Nortcel/cosine-response-test-bench/licenses/README.txt

Licence allocation
Original hardware design files: CERN-OHL-S-2.0.
Original controller, firmware and analysis code: MIT.
Original documentation, photographs and datasets: CC-BY-4.0.
Third-party components retain their own terms. Preserve existing notices. See THIRD_PARTY_MATERIALS.txt.
The root repository MIT licence does not override these per-material allocations.
