Nortcel/cosine-response-test-bench/data/optical_graph_transcription/Historical_graph_with_labels.jpg

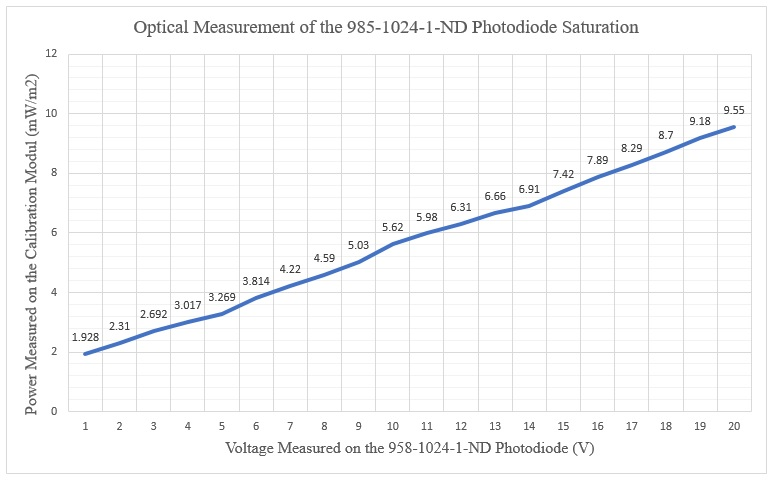
data/optical_graph_transcription/Historical_graph_with_labels.jpg
