Nortcel/cosine-response-test-bench/data/optical_graph_transcription/source_images/image2.png

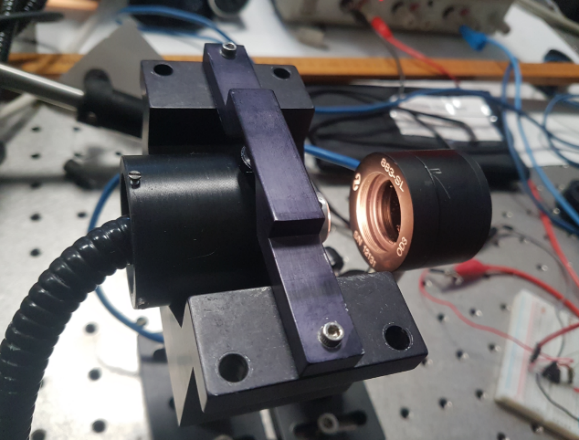
data/optical_graph_transcription/source_images/image2.png
