Nortcel/cosine-response-test-bench/data/optical_graph_transcription/source_images/image4.png

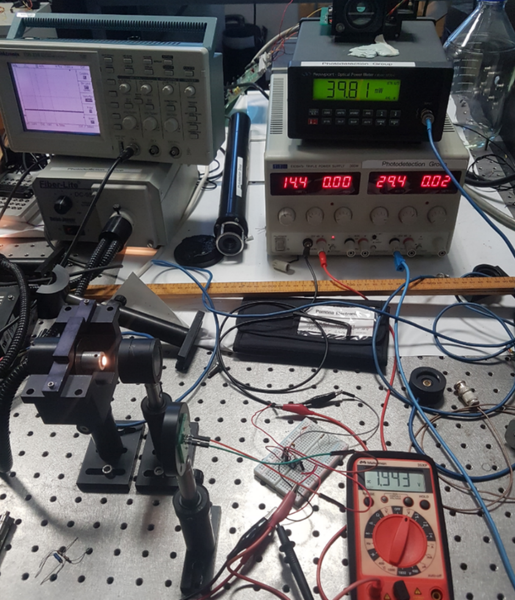
data/optical_graph_transcription/source_images/image4.png
