Nortcel/cosine-response-test-bench/figures/Figure_4_desktop_controller_V26_7.jpg

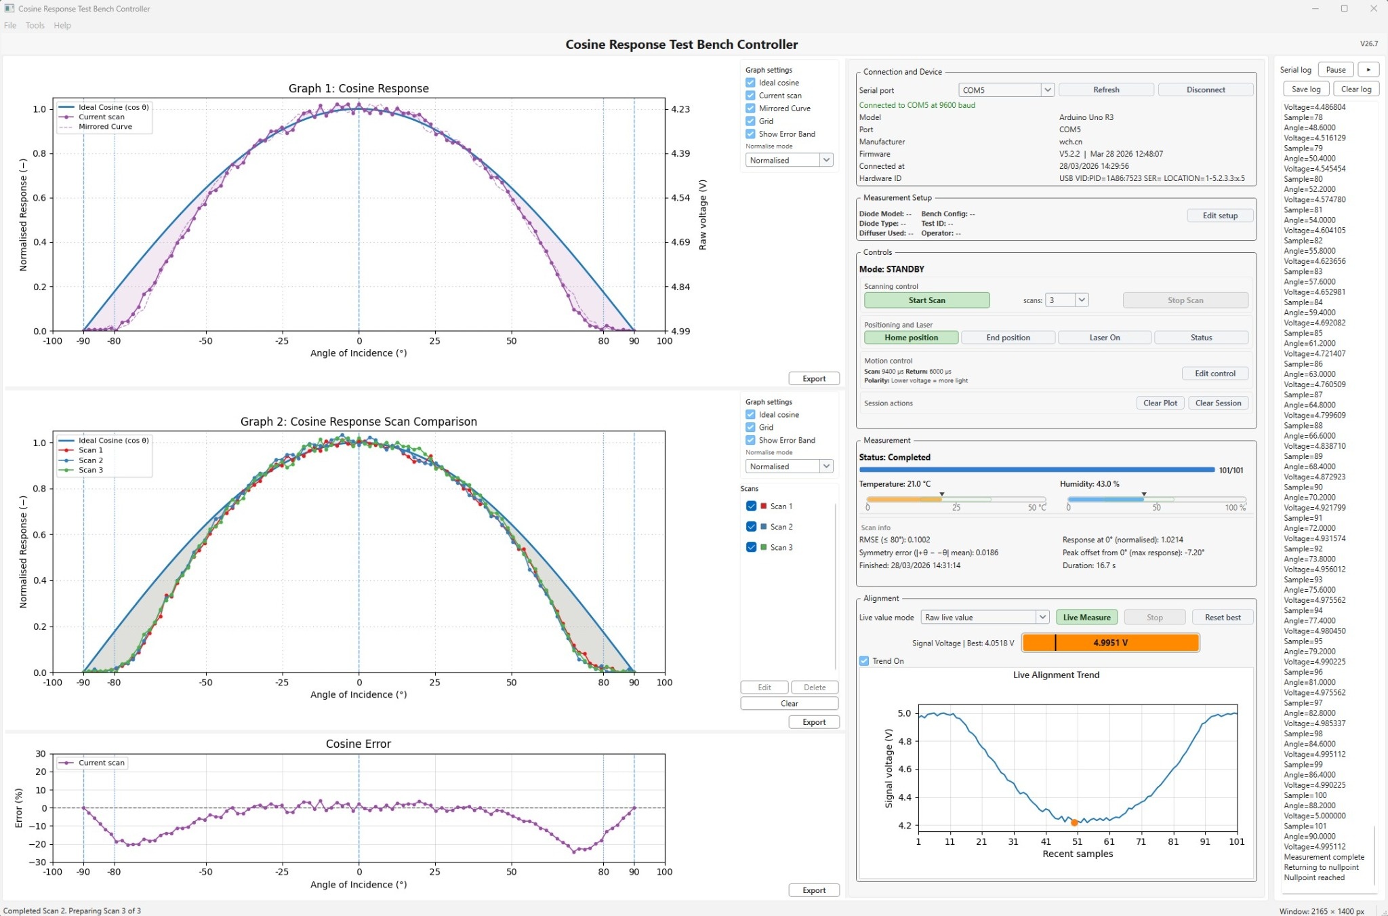
figures/Figure_4_desktop_controller_V26_7.jpg
