Nortcel/cosine-response-test-bench/hardware/photos/CRTB - (B) Laser alignment.jpg

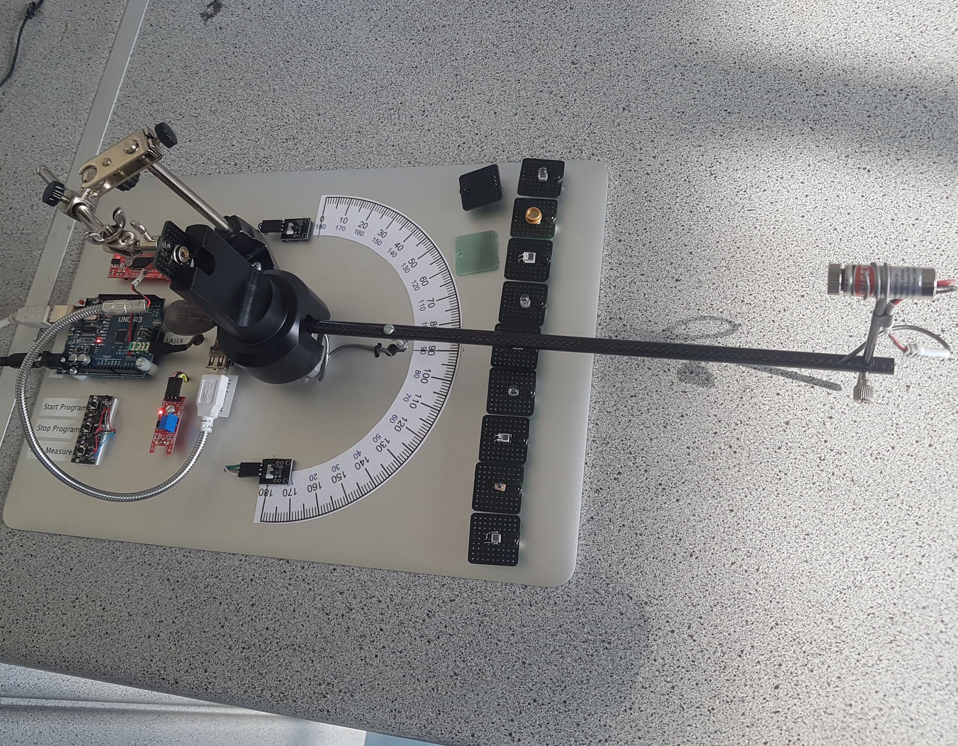
hardware/photos/CRTB - (B) Laser alignment.jpg
