Nortcel/cosine-response-test-bench/hardware/bill_of_materials/Bill_of_materials_corrected.xlsx

 | Arduino Cosine Response Test Bench V1.3
 | Part | Model | pcs | Price | Cost | Link
Hardware | Base Plate | MacBook Screen Lid (Second Hand) | 1 |  | second hand
 | Diode Mount Arm | Third Helping Hand Model Airfix | 1 | €16.70 | €16.70 | Diode Mount Arm (https://www.ebay.ie/itm/316761165925)
 | Long Arm | W-8mm L-500mm 3k Carbon Fiber Tube | 1 | €28.00 | €28.00 | Long Arm (http://www.ebay.ie/itm/1-x-OD-8mm-x-ID-6mm-x-Length-500mm-3k-Carbon-Fiber-Tube-Roll-Wrapped/331740265029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)
 | Short Arm | 5x Carbon Fiber tubes 4 x 2 x 200mm | 1 | €22.00 | €22.00 | Short Arm (https://www.ebay.ie/itm/114634828562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)
 | Balance Weight | 88 Gram Lead Weight | 1 |  | second hand
 | Hihg flexibility cable | Nokia headset cable | 1 |  | second hand
 | Flexible Cable mount | USB Flexible Light Gooseneck Led Lamp | 1 | €4.50 | €4.50 | Flexible Cable mount (https://www.ebay.ie/itm/227135376883?_skw=usb+flexible+led&itmmeta=01KM2GMV5ENJ29FJ3D4737PT9P)
 | Stepper Motor | Nema 17 Stepper Motor Bipolar | 1 | €22.00 | €22.00 | Stepper Motor (https://www.ebay.ie/itm/318027631379?_skw=4-Lead+Nema+17+Stepper+Motor&itmmeta=01KM2EH9Q5C54ABEY4RGEM3MFD)
 | Screws | Screws and nuts | ~14 |  | second hand
 | Labels |  | 9 |  | printed
 | Alignment tool | Photo Diode PCB Alignment Tool | 1 |  | 3D printed
 | Laser Cap | Reflection Mitigation Cap | 1 |  | 3D printed
 | Small PCB Boards | Photodiode mounting pcb board | 10
Electronics | Laser Module | 650nm 5mW Red Laser Adjustable Focus | 1 | €8.65 | €8.65 | Laser Module (http://www.ebay.ie/itm/650nm-5mW-Red-Laser-Line-Module-HLM1230-IIIa-Adjustable-Focus-Flux-Workshop/111609050407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)
 | Motor Driver | EasyDriver Stepper motor driver V4.4 | 1 | €22.45 | €22.45 | Motor Driver (https://www.ebay.ie/itm/157683697601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)
 | Arduino | UNO R3 Rev3 Board | 1 | €7.88 | €7.88 | Arduino R3 (https://www.ebay.ie/itm/376626792380?_skw=uno+r3+board&itmmeta=01KM2EDS5HD6CFMYX3822DTQXC)
 | USB board | Flexible arm mount base | 1 |  | second hand
 | Wires | 10/20/40 pcs Breadboard Jump Wire | 1 | €10.00 | €10.00 | Wires (http://www.ebay.ie/itm/10-20-40-pcs-Breadboard-Dupont-Jump-Wire-M-M-M-F-F-F-10-20cm-Jumper-Cable-Lead/122177310007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)
 | Power supply (9.5V) | NSA30B-2 | 1 | €22.00 | €22.00 | Power Supply (https://www.ebay.ie/itm/147177990800?_skw=9.5V+3A&itmmeta=01KM2HJW89XA2T8Z64F7B6GMC5)
 | USB B Printer cable | 2 meters | 1 | €3.00 | €3.00 | USB B Printer cable (https://www.ebay.ie/itm/197728840919?_skw=USB+B+Printer+cable&itmmeta=01KM2J6KRAH8B1QASN47B5Z5PF)
Sensor Kit | Key switch module | KY-004 | 3 | €15.00 | €45.00 | Sensor Pack (http://www.ebay.ie/itm/37-Sensor-Ultimate-37-in-1-Sensor-Modules-Kit-for-Arduino-MCU-Education-User-ck-/191958644105)
 | Temp. & Humidity sensor | KY-015 | 1 |  | included
 | Optical broken module | KY-010 | 2 |  | included
 | Signal amplifier | Infrared diode signal amplifier | 1 |  | included
 |  |  | SUM |  | €212.18
 | Photodiodes
 | Module | Model | pcs | Price | Cost | Link
 | Photodiode 1 | 475-1077-ND | 1 | €0.73 | €0.73 | digikey (https://www.digikey.hu/en)
 | Photodiode 2 | ODD-5W-ND | 1 | €53.22 | €53.22
 | Photodiode 3 | ODD-3W-2-ND | 1 | €38.48 | €38.48
 | Photodiode 4 | 958-1024-1-ND | 1 | €2.78 | €2.78
 | Photodiode 5 | 1080-1143-ND | 1 | €0.77 | €0.77
 | Photodiode 6 | 1080-1148-ND | 1 | €1.05 | €1.05
 | Photodiode 7 | 1080-1144-ND | 1 | €0.91 | €0.91
 | Photodiode 8 | PDB-C134-ND | 1 | €1.70 | €1.70
 | Photodiode 9 | PDB-C139-ND | 1 | €3.89 | €3.89
 | Photodiode 10 | PDB-C158-ND | 1 | €3.00 | €3.00
 |  |  | SUM |  | €106.53
