Nortcel/cosine-response-test-bench/hardware/electronics/pinout.csv

Arduino pin | Function | Mode | Notes
D2 | Start pushbutton | Input with internal pull-up | Active LOW
D3 | Stop pushbutton | Input with internal pull-up | Active LOW
D4 | Free/alignment pushbutton | Input with internal pull-up | Active LOW
D5 | Home optical interrupter | Digital input | Active HIGH
D6 | End optical interrupter | Digital input | Active HIGH
D7 | Laser enable | Digital output | HIGH = on
D8 | EasyDriver direction | Digital output | LOW = forward scan
D9 | EasyDriver step pulse | Digital output | One pulse per microstep
D10 | DHT11 data | Digital input | Temperature and humidity
D12 | EasyDriver enable | Digital output | LOW = motor enabled
A1 | Detector signal | Analogue input | 0-5 V, 10-bit ADC
