Nortcel/cosine-response-test-bench/data/optical_graph_transcription/Optical_measurements_transcribed.csv

point | voltage_V | reference_reading | printed_label | provenance | reference_unit_status
1 | 1 | 1.928 | 1.928 | Transcribed numeric label; not original instrument record | Unresolved: historical axis W/m2; later figure mW
2 | 2 | 2.31 | 2.31 | Transcribed numeric label; not original instrument record | Unresolved: historical axis W/m2; later figure mW
3 | 3 | 2.692 | 2.692 | Transcribed numeric label; not original instrument record | Unresolved: historical axis W/m2; later figure mW
4 | 4 | 3.017 | 3.017 | Transcribed numeric label; not original instrument record | Unresolved: historical axis W/m2; later figure mW
5 | 5 | 3.269 | 3.269 | Transcribed numeric label; not original instrument record | Unresolved: historical axis W/m2; later figure mW
6 | 6 | 3.814 | 3.814 | Transcribed numeric label; not original instrument record | Unresolved: historical axis W/m2; later figure mW
7 | 7 | 4.22 | 4.22 | Transcribed numeric label; not original instrument record | Unresolved: historical axis W/m2; later figure mW
8 | 8 | 4.59 | 4.59 | Transcribed numeric label; not original instrument record | Unresolved: historical axis W/m2; later figure mW
9 | 9 | 5.03 | 5.03 | Transcribed numeric label; not original instrument record | Unresolved: historical axis W/m2; later figure mW
10 | 10 | 5.62 | 5.62 | Transcribed numeric label; not original instrument record | Unresolved: historical axis W/m2; later figure mW
11 | 11 | 5.98 | 5.98 | Transcribed numeric label; not original instrument record | Unresolved: historical axis W/m2; later figure mW
12 | 12 | 6.31 | 6.31 | Transcribed numeric label; not original instrument record | Unresolved: historical axis W/m2; later figure mW
13 | 13 | 6.66 | 6.66 | Transcribed numeric label; not original instrument record | Unresolved: historical axis W/m2; later figure mW
14 | 14 | 6.91 | 6.91 | Transcribed numeric label; not original instrument record | Unresolved: historical axis W/m2; later figure mW
15 | 15 | 7.42 | 7.42 | Transcribed numeric label; not original instrument record | Unresolved: historical axis W/m2; later figure mW
16 | 16 | 7.89 | 7.89 | Transcribed numeric label; not original instrument record | Unresolved: historical axis W/m2; later figure mW
17 | 17 | 8.29 | 8.29 | Transcribed numeric label; not original instrument record | Unresolved: historical axis W/m2; later figure mW
18 | 18 | 8.7 | 8.7 | Transcribed numeric label; not original instrument record | Unresolved: historical axis W/m2; later figure mW
19 | 19 | 9.18 | 9.18 | Transcribed numeric label; not original instrument record | Unresolved: historical axis W/m2; later figure mW
20 | 20 | 9.55 | 9.55 | Transcribed numeric label; not original instrument record | Unresolved: historical axis W/m2; later figure mW
