Nortcel/cosine-response-test-bench/(list of files, cad)

Other CAD files:
hardware/cad/Cosine_Response_Test_Bench_Alignment_Stand.skp
hardware/cad/Cosine_Response_Test_Bench_Laser_Cover.skp
