Nortcel/cosine-response-test-bench/data/workbook_cohort/1080-1144-ND Diode Measurement V1.xlsx

Measurement 1 |  |  |  |  | Measurement 2 |  |  |  |  | Measurement 3 |  |  |  |  | Average of 3 measurements
Set to nullpoint! |  |  |  |  | Set to nullpoint! |  |  |  |  | Set to nullpoint! |  |  |  |  |  |  | Humidity = | 62.00
LeftPIR |  |  |  |  | LeftPIR |  |  |  |  | LeftPIR |  |  |  |  |  |  | Temperature = | 24.00
Humidity = | 62 | Temperature = | 24 | 23 | Humidity = | 62 | Temperature = | 24 | 23 | Humidity = | 62 | Temperature = | 24 | 23 | No. | Sensor Voltage | Measured Cosine | Real Cosine | Solar Zenith Angle (degrees)
Voltage = | 5 |  |  |  | Voltage = | 5 |  |  |  | Voltage = | 5 |  |  |  | 0 | 5.00 | 0.00 | 6.125742275e-17 | -90.0
Voltage = | 5 |  |  |  | Voltage = | 5 |  |  |  | Voltage = | 5 |  |  |  | 1 | 5.00 | 0.00 | 0.03 | -88.2
Voltage = | 5 |  |  |  | Voltage = | 5 |  |  |  | Voltage = | 5 |  |  |  | 2 | 5.00 | 0.00 | 0.06 | -86.4
Voltage = | 5 |  |  |  | Voltage = | 5 |  |  |  | Voltage = | 5 |  |  |  | 3 | 5.00 | 0.00 | 0.09 | -84.6
Voltage = | 5 |  |  |  | Voltage = | 5 |  |  |  | Voltage = | 5 |  |  |  | 4 | 5.00 | 0.00 | 0.13 | -82.8
Voltage = | 5 |  |  |  | Voltage = | 5 |  |  |  | Voltage = | 5 |  |  |  | 5 | 5.00 | 0.00 | 0.16 | -81.0
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
