Nortcel/cosine-response-test-bench/data/workbook_cohort/1080-1148-ND Diode Measurement V1.xlsx

Measurement 1 |  |  |  | Measurement 2 |  |  |  | Measurement 1 |  |  |  | Average of 3 measurements
 |  |  |  |  |  |  |  |  |  |  |  |  |  | Humidity = | 34.00
Set to nullpoint! |  |  |  | Set to nullpoint! |  |  |  | Set to nullpoint! |  |  |  |  |  | Temperature = | 22.00
Humidity = | 35 | Temperature = | 22 | Humidity = | 34 | Temperature = | 22 | Humidity = | 33 | Temperature = | 22 | No. | Sensor Voltage | Measured Cosine | Real Cosine | Solar Zenith Angle (degrees)
Voltage = | 4.97 |  |  | Voltage = | 4.96 |  |  | Voltage = | 4.97 |  |  | 0 | 5.00 | 0.00 | 6.125742275e-17 | -90.0
Voltage = | 4.96 |  |  | Voltage = | 4.96 |  |  | Voltage = | 4.95 |  |  | 1 | 4.97 | 0.03 | 0.03 | -88.2
Voltage = | 4.95 |  |  | Voltage = | 4.95 |  |  | Voltage = | 4.95 |  |  | 2 | 4.96 | 0.04 | 0.06 | -86.4
Voltage = | 4.93 |  |  | Voltage = | 4.94 |  |  | Voltage = | 4.93 |  |  | 3 | 4.95 | 0.05 | 0.09 | -84.6
Voltage = | 4.92 |  |  | Voltage = | 4.92 |  |  | Voltage = | 4.92 |  |  | 4 | 4.93 | 0.07 | 0.13 | -82.8
Voltage = | 4.91 |  |  | Voltage = | 4.91 |  |  | Voltage = | 4.91 |  |  | 5 | 4.92 | 0.08 | 0.16 | -81.0
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
