Nortcel/cosine-response-test-bench/data/workbook_cohort/ODD-3W-2-ND Diode Measurement V1.xlsx

Measurement 1 |  |  |  | Measurement 2 |  |  |  | Measurement 3 |  |  |  | Average of 3 measurements
 |  |  |  |  |  |  |  |  |  |  |  |  |  | Humidity = | 35.67
Set to nullpoint! |  |  |  |  |  |  |  | Set to nullpoint! |  |  |  |  |  | Temperature = | 22.00
Humidity = | 37 | Temperature = | 22 | Humidity = | 36 | Temperature = | 22 | Humidity = | 34 | Temperature = | 22 | No. | Sensor Voltage | Measured Cosine | Real Cosine | Solar Zenith Angle (degrees)
Voltage = | 5 |  |  | Voltage = | 4.99 |  |  | Voltage = | 5 |  |  | 0 | 5.00 | 0.00 | 6.125742275e-17 | -90.0
Voltage = | 5 |  |  | Voltage = | 5 |  |  | Voltage = | 5 |  |  | 1 | 5.00 | 0.003333333333 | 0.03 | -88.2
Voltage = | 5 |  |  | Voltage = | 5 |  |  | Voltage = | 5 |  |  | 2 | 5.00 | 0.00 | 0.06 | -86.4
Voltage = | 5 |  |  | Voltage = | 4.99 |  |  | Voltage = | 4.99 |  |  | 3 | 5.00 | 0.00 | 0.09 | -84.6
Voltage = | 4.99 |  |  | Voltage = | 5 |  |  | Voltage = | 4.99 |  |  | 4 | 4.99 | 0.01 | 0.13 | -82.8
Voltage = | 4.99 |  |  | Voltage = | 4.98 |  |  | Voltage = | 4.99 |  |  | 5 | 4.99 | 0.01 | 0.16 | -81.0
Voltage = | 5 |  |  | Voltage = | 4.99 |  |  | Voltage = | 4.97 |  |  | 6 | 4.99 | 0.01 | 0.19 | -79.2
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
