Nortcel/cosine-response-test-bench/figures/Figure_2_measurement_geometry.pdf

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

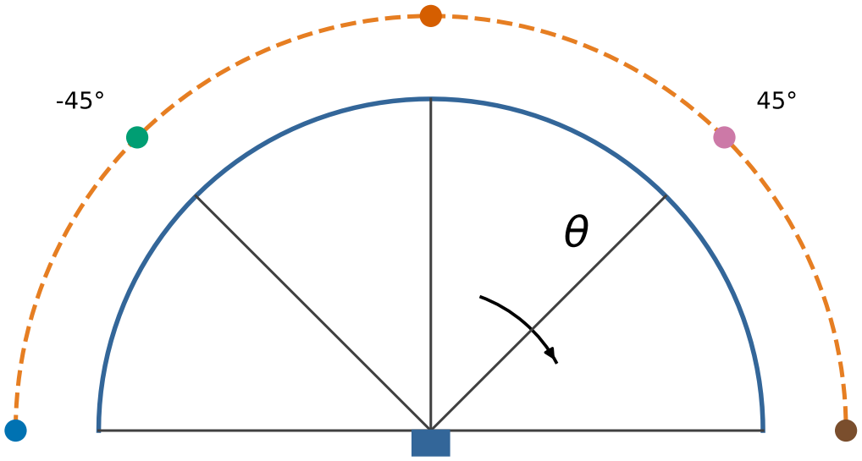
[picture p8: figure]
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
