Nortcel/cosine-response-test-bench/hardware/electronics/Cosine_Response_Test_Bench_Circuit_Diagram.jpg

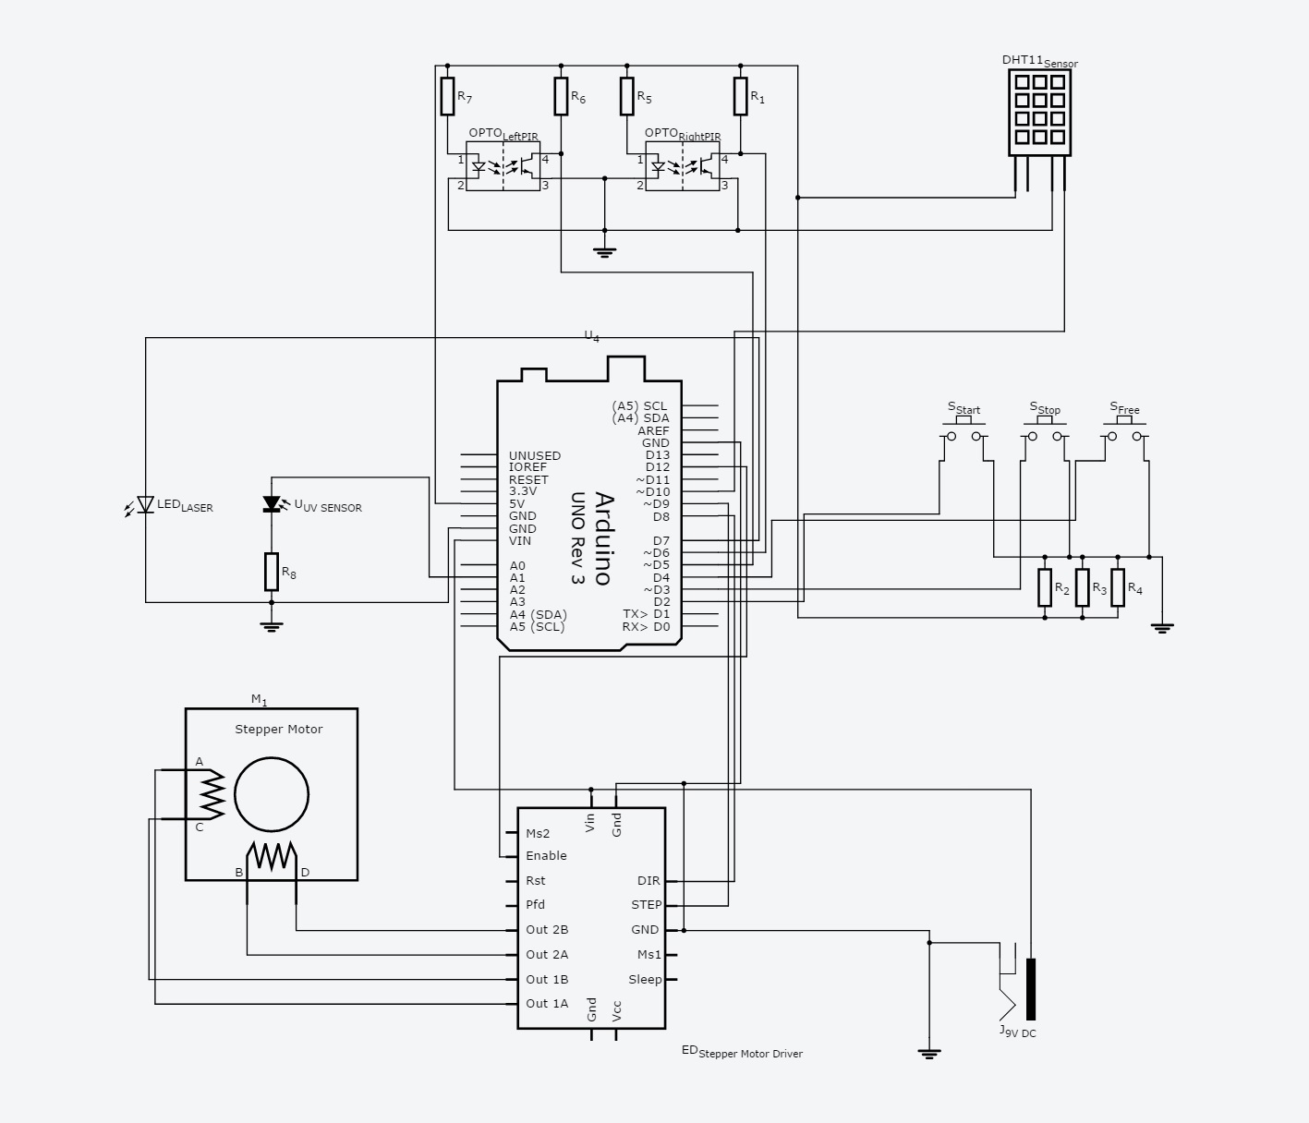
hardware/electronics/Cosine_Response_Test_Bench_Circuit_Diagram.jpg
