Nortcel/cosine-response-test-bench/hardware/photos/CRTB - (D) Completed measurement arrangement.png

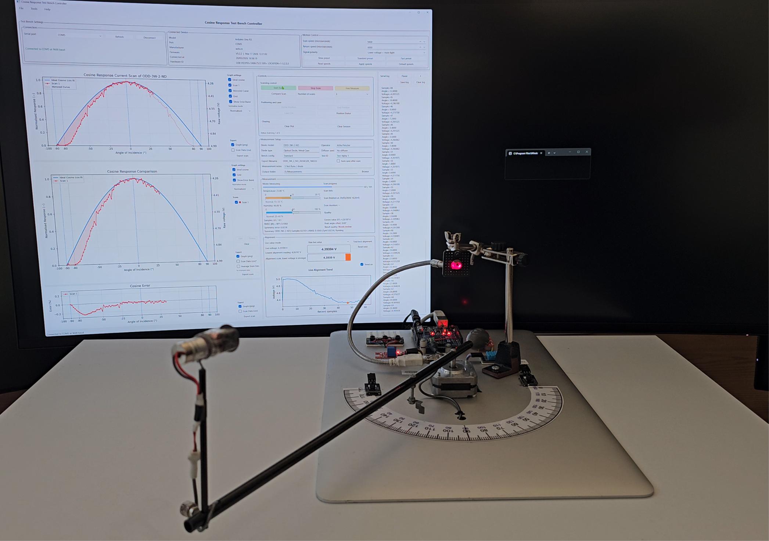
hardware/photos/CRTB - (D) Completed measurement arrangement.png
