Nortcel/cosine-response-test-bench/software/source/Controller_V26_7_RELEASE.py

# Fixed runnable copy based on the uploaded V11_2_grouped.py
import csv
import json
import math
import queue
import re
import sys
import threading
import time
import traceback
import tempfile
from collections import deque
from dataclasses import dataclass
from pathlib import Path
from typing import Callable, Deque, List, Optional, Sequence, Tuple

try:
    import serial
    import serial.tools.list_ports
except ImportError:
    serial = None

try:
    from PySide6.QtCore import QTimer, Qt, QUrl, QPoint, QRectF
    from PySide6.QtGui import QColor, QFont, QKeySequence, QShortcut, QPixmap, QIcon, QPainter, QPen, QBrush, QDesktopServices
    from PySide6.QtWidgets import (
        QApplication,
        QCheckBox,
        QComboBox,
        QDialog,
        QDialogButtonBox,
        QFileDialog,
        QFrame,
        QGroupBox,
        QGridLayout,
        QHBoxLayout,
        QLabel,
        QLineEdit,
        QMainWindow,
        QMenuBar,
        QSpinBox,
        QMessageBox,
        QPushButton,
        QPlainTextEdit,
        QProgressBar,
        QScrollArea,
        QListWidget,
        QListWidgetItem,
        QInputDialog,
        QSizePolicy,
        QColorDialog,
        QAbstractItemView,
        QSplitter,
        QVBoxLayout,
        QWidget,
    )
except ImportError:
    QApplication = None

try:
    import matplotlib

    matplotlib.use("QtAgg")
    from matplotlib.backends.backend_qtagg import FigureCanvasQTAgg as FigureCanvas
    from matplotlib.figure import Figure
except ImportError:
    FigureCanvas = None
    Figure = None


APP_TITLE = "Cosine Response Test Bench Controller"
APP_VERSION = "26.7"
APP_RELEASE_DATE = "27 March 2026"
APP_DEVELOPER = "Attila Preszter"
CHANGELOG_URL = "https://github.com/Nortcel/cosine-response-test-bench/releases"
ERROR_LOG_FILE = "cosine_bench_error.log"
SETTINGS_FILE = "cosine_bench_settings.json"
BAUD_RATE = 9600
MAX_POINTS = 101
MAX_COMPARE_SCANS = 8
READ_TIMEOUT = 0.2
POLARITY_HIGHER_IS_MORE = "Higher voltage = more light"

POLARITY_LOWER_IS_MORE = "Lower voltage = more light"

BUTTON_ACTIVE_STYLE = "QPushButton { background-color: #c9e8c9; border: 1px solid #73a973; border-radius: 4px; color: #163816; font-weight: 700; } QPushButton:disabled { background-color: #ececec; border: 1px solid #c9c9c9; border-radius: 4px; color: #9a9a9a; }"
BUTTON_INACTIVE_STYLE = "QPushButton { background-color: #b8b8b8; border: 1px solid #8f8f8f; border-radius: 4px; color: #2f2f2f; font-weight: 600; } QPushButton:disabled { background-color: #ececec; border: 1px solid #c9c9c9; border-radius: 4px; color: #9a9a9a; }"
BUTTON_DISABLED_STYLE = "QPushButton { background-color: #ececec; border: 1px solid #c9c9c9; border-radius: 4px; color: #9a9a9a; font-weight: 600; }"
BUTTON_MOVING_STYLE = "QPushButton { background-color: #f6d7a7; border: 1px solid #d4ad68; border-radius: 4px; color: #5d430d; font-weight: 600; } QPushButton:disabled { background-color: #ececec; border: 1px solid #c9c9c9; border-radius: 4px; color: #9a9a9a; }"
BUTTON_LASER_ON_STYLE = "QPushButton { background-color: #e39aa2; border: 1px solid #c96d7c; border-radius: 4px; color: #6f1020; font-weight: 700; } QPushButton:disabled { background-color: #ececec; border: 1px solid #c9c9c9; border-radius: 4px; color: #9a9a9a; }"
BUTTON_NEUTRAL_STYLE = "QPushButton { background-color: #f3f4f6; border: 1px solid #c4cad2; border-radius: 4px; color: #374151; font-weight: 600; } QPushButton:pressed { background-color: #e1e5ea; } QPushButton:disabled { background-color: #ececec; border: 1px solid #c9c9c9; border-radius: 4px; color: #9a9a9a; }"
RESET_BEST_BUTTON_STYLE = "QPushButton { background-color: #f3f4f6; border: 1px solid #c4cad2; border-radius: 4px; color: #374151; font-weight: 600; padding: 0 10px; } QPushButton:pressed { background-color: #e1e5ea; border-color: #9aa4b2; padding-top: 1px; padding-left: 11px; } QPushButton:disabled { background-color: #ececec; border: 1px solid #c9c9c9; border-radius: 4px; color: #9a9a9a; }"
BUTTON_PRESS_FEEDBACK_STYLE = RESET_BEST_BUTTON_STYLE
SOFTWARE_CHECK_BLUE = "#78BFFF"
SOFTWARE_CHECK_BLUE_HOVER = "#8DCCFF"
UI_ASSET_DIR = Path(tempfile.gettempdir()) / "cosine_bench_ui_assets"
UI_ASSET_DIR.mkdir(parents=True, exist_ok=True)
CHECK_TICK_ICON = UI_ASSET_DIR / "checkbox_tick_24_6.svg"
COMBO_ARROW_ICON = UI_ASSET_DIR / "combo_arrow_24_6.svg"
if not CHECK_TICK_ICON.exists():
    CHECK_TICK_ICON.write_text(
        "<svg xmlns=\"http://www.w3.org/2000/svg\" width=\"14\" height=\"14\" viewBox=\"0 0 14 14\"><path d=\"M3 7.2l2.2 2.4L11 4.3\" fill=\"none\" stroke=\"#ffffff\" stroke-width=\"2.1\" stroke-linecap=\"round\" stroke-linejoin=\"round\"/></svg>",
        encoding="utf-8",
    )
if not COMBO_ARROW_ICON.exists():
    COMBO_ARROW_ICON.write_text(
        "<svg xmlns=\"http://www.w3.org/2000/svg\" width=\"10\" height=\"6\" viewBox=\"0 0 10 6\"><path d=\"M1 1l4 4 4-4\" fill=\"none\" stroke=\"#5f6d7a\" stroke-width=\"1.6\" stroke-linecap=\"round\" stroke-linejoin=\"round\"/></svg>",
        encoding="utf-8",
    )
APP_UI_STYLE = f"""
QCheckBox {{
    spacing: 6px;
}}
QCheckBox::indicator {{
    width: 13px;
    height: 13px;
    border: 1px solid #748292;
    border-radius: 2px;
    background: #ffffff;
}}
QCheckBox::indicator:unchecked:hover {{
    border-color: #637180;
    background: #f7fbff;
}}
QCheckBox::indicator:checked {{
    background: {SOFTWARE_CHECK_BLUE};
    border: 1px solid #63AFEA;
    image: url({CHECK_TICK_ICON.as_posix()});
}}
QCheckBox::indicator:checked:hover {{
    background: {SOFTWARE_CHECK_BLUE_HOVER};
    border-color: #63AFEA;
    image: url({CHECK_TICK_ICON.as_posix()});
}}
QComboBox {{
    border: 1px solid #9EA8B3;
    border-radius: 3px;
    background: #ffffff;
    padding: 1px 24px 1px 6px;
}}
QComboBox:hover {{
    border-color: #8A95A1;
}}
QComboBox::drop-down {{
    subcontrol-origin: padding;
    subcontrol-position: top right;
    width: 20px;
    border-left: 1px solid #AAB4BE;
    background: #f7f7f7;
    border-top-right-radius: 3px;
    border-bottom-right-radius: 3px;
}}
QComboBox::down-arrow {{
    image: url({COMBO_ARROW_ICON.as_posix()});
    width: 10px;
    height: 6px;
}}
QComboBox QAbstractItemView {{
    border: 1px solid #86919C;
    background: #ffffff;
    selection-background-color: #D7EEFF;
    selection-color: #111111;
    outline: 0;
}}
"""


WINDOW_GROUPBOX_STYLE = "QGroupBox { background-color: #f7f7f7; padding-top: 12px; margin-top: 8px; } QGroupBox::title { subcontrol-origin: margin; left: 8px; padding: 0 3px 0 3px; }"
WINDOW_FRAME_STYLE = "background-color: #f7f7f7;"


class EnvironmentGauge(QWidget):
    def __init__(self, min_value=0.0, max_value=100.0, normal_min=None, normal_max=None, units="", fill_colour="#64b5f6", parent=None):
        super().__init__(parent)
        self.min_value = float(min_value)
        self.max_value = float(max_value)
        self.normal_min = None if normal_min is None else float(normal_min)
        self.normal_max = None if normal_max is None else float(normal_max)
        self.units = units
        self.fill_colour = QColor(fill_colour)
        self.value = None
        self.setMinimumHeight(34)
        self.setMaximumHeight(38)
        self.setMinimumWidth(180)
        self.setMaximumWidth(16777215)
        self.setSizePolicy(QSizePolicy.Expanding, QSizePolicy.Fixed)

    def setValueFloat(self, value):
        self.value = None if value is None else float(value)
        self.update()

    def _x_for_value(self, value, left, width):
        if self.max_value <= self.min_value:
            return left
        ratio = (value - self.min_value) / (self.max_value - self.min_value)
        ratio = max(0.0, min(1.0, ratio))
        return left + ratio * width

    def paintEvent(self, event):
        painter = QPainter(self)
        painter.setRenderHint(QPainter.Antialiasing, True)

        rect = self.rect()
        left = 12
        right = rect.width() - 12
        track_y = 12
        track_h = 8
        track_w = max(0, right - left)

        fm = painter.fontMetrics()
        tick_label_y = rect.height() - 1

        ticks = [
            (self.min_value, f"{int(self.min_value)}"),
            ((self.min_value + self.max_value) / 2.0, f"{int((self.min_value + self.max_value) / 2.0)}"),
            (self.max_value, f"{int(self.max_value)} {self.units}".rstrip()),
        ]

        painter.setPen(QPen(QColor("#a8a8a8"), 1))
        painter.setBrush(QBrush(QColor("#f5f5f5")))
        painter.drawRoundedRect(left, track_y, track_w, track_h, 4, 4)

        if self.value is not None:
            vx = self._x_for_value(self.value, left, track_w)
            fill_w = max(0, int(vx - left))
            painter.setPen(Qt.NoPen)
            painter.setBrush(QBrush(self.fill_colour))
            painter.drawRoundedRect(left + 1, track_y + 1, max(0, fill_w - 1), track_h - 2, 3, 3)

        if self.normal_min is not None and self.normal_max is not None:
            n1 = self._x_for_value(self.normal_min, left, track_w)
            n2 = self._x_for_value(self.normal_max, left, track_w)
            band_x = int(min(n1, n2))
            band_w = int(abs(n2 - n1))
            painter.setPen(QPen(QColor(129, 199, 132, 170), 1))
            painter.setBrush(Qt.NoBrush)
            painter.drawRoundedRect(band_x, track_y + 1, band_w, track_h - 2, 3, 3)

        painter.setPen(QPen(QColor("#777777"), 1))
        for tick_val, _label in ticks:
            x = int(self._x_for_value(tick_val, left, track_w))
            painter.drawLine(x, track_y + track_h + 1, x, track_y + track_h + 4)

        if self.value is not None:
            vx = int(self._x_for_value(self.value, left, track_w))
            painter.setPen(Qt.NoPen)
            painter.setBrush(QBrush(QColor("#444444")))
            points = [
                (vx, track_y - 1),
                (vx - 4, track_y - 7),
                (vx + 4, track_y - 7),
            ]
            from PySide6.QtCore import QPoint
            painter.drawPolygon([QPoint(x, y) for x, y in points])

        painter.setPen(QPen(QColor("#666666"), 1))
        for tick_val, label in ticks:
            x = self._x_for_value(tick_val, left, track_w)
            label_w = fm.horizontalAdvance(label)
            label_x = int(x - label_w * 0.5)
            if tick_val == self.min_value:
                label_x = left - 2
            elif tick_val == self.max_value:
                label_x = right - label_w
            painter.drawText(label_x, tick_label_y, label)

        painter.end()


class AlignmentStrengthBar(QWidget):
    def __init__(self, min_value=0.0, max_value=5000.0, parent=None):
        super().__init__(parent)
        self.min_value = float(min_value)
        self.max_value = float(max_value)
        self.value = None
        self.best_value = None
        self.display_text = None
        self.inverted_appearance = False
        self.setMinimumHeight(32)
        self.setMaximumHeight(34)
        self.setSizePolicy(QSizePolicy.Expanding, QSizePolicy.Fixed)

    def setRange(self, min_value, max_value):
        self.min_value = float(min_value)
        self.max_value = float(max_value)
        self.update()

    def setValue(self, value):
        self.value = None if value is None else float(value)
        self.update()

    def setFormat(self, text):
        self.display_text = text
        self.update()

    def setInvertedAppearance(self, inverted):
        self.inverted_appearance = bool(inverted)
        self.update()

    def setBestValue(self, best_value):
        self.best_value = None if best_value is None else float(best_value)
        self.update()

    def setValueData(self, value, best_value=None):
        self.value = None if value is None else float(value)
        self.best_value = None if best_value is None else float(best_value)
        self.update()

    def _x_for_value(self, value, left, width):
        if self.max_value <= self.min_value:
            return left
        ratio = (value - self.min_value) / (self.max_value - self.min_value)
        ratio = max(0.0, min(1.0, ratio))
        return left + ratio * width

    def paintEvent(self, event):
        painter = QPainter(self)
        painter.setRenderHint(QPainter.Antialiasing, True)

        rect = self.rect()
        left = 1
        top = 1
        width = max(0, rect.width() - 2)
        height = max(0, rect.height() - 2)

        painter.setPen(QPen(QColor('#777777'), 1))
        painter.setBrush(QBrush(QColor('#ffffff')))
        painter.drawRoundedRect(left, top, width, height, 4, 4)

        track_left = left + 2
        track_top = top + 2
        track_width = max(0, width - 4)
        track_height = max(0, height - 4)

        if self.value is not None:
            value_x = self._x_for_value(self.value, track_left, track_width)
            if self.inverted_appearance:
                fill_rect = QRectF(value_x, track_top, max(0.0, track_left + track_width - value_x), track_height)
            else:
                fill_rect = QRectF(track_left, track_top, max(0.0, value_x - track_left), track_height)
            painter.setPen(Qt.NoPen)
            painter.setBrush(QBrush(QColor('#ff8a00')))
            painter.drawRoundedRect(fill_rect, 3, 3)

        if self.best_value is not None:
            bx = int(self._x_for_value(self.best_value, track_left, track_width))
            painter.setPen(QPen(QColor('#000000'), 2))
            painter.drawLine(bx, track_top + 1, bx, track_top + track_height - 1)

        text_value = self.display_text if self.display_text is not None else ('-- V' if self.value is None else f'{self.value:.4f} V')
        painter.setPen(QPen(QColor('#111111'), 1))
        font = painter.font()
        font.setBold(True)
        font.setPointSize(max(10, font.pointSize()))
        painter.setFont(font)
        painter.drawText(rect, Qt.AlignCenter, text_value)
        painter.end()


@dataclass
class ParsedState:
    mode: str = "Idle"
    temperature_c: Optional[float] = None
    humidity_percent: Optional[float] = None
    live_voltage_v: Optional[float] = None
    samples: int = 0
    interrupted: bool = False


@dataclass
class SamplePoint:
    index: int
    angle_deg: float
    voltage: float


@dataclass
class ScanRecord:
    label: str
    diode_model: str
    samples: list
    colour: str = "#ff5a1f"
    interrupted: bool = False


class SerialWorker:
    def __init__(self, on_line_callback: Callable[[str], None], on_status_callback: Callable[[str], None]):
        self.on_line_callback = on_line_callback
        self.on_status_callback = on_status_callback
        self.ser = None
        self.thread = None
        self.stop_event = threading.Event()
        self.write_lock = threading.Lock()

    def connect(self, port: str, baud_rate: int = BAUD_RATE):
        if serial is None:
            raise RuntimeError("pyserial is not installed. Install it with: pip install pyserial")
        self.disconnect(notify=False)
        self.stop_event.clear()
        self.ser = serial.Serial(port, baud_rate, timeout=READ_TIMEOUT)
        self.thread = threading.Thread(target=self._reader_loop, daemon=True)
        self.thread.start()
        self.on_status_callback(f"Connected to {port} at {baud_rate} baud")

    def disconnect(self, notify: bool = True):
        self.stop_event.set()
        if self.thread and self.thread.is_alive():
            self.thread.join(timeout=1.0)
        self.thread = None
        if self.ser:
            try:
                if self.ser.is_open:
                    self.ser.close()
            except Exception:
                pass
        self.ser = None
        if notify:
            self.on_status_callback("Disconnected")

    def send(self, command: str):
        if not self.ser or not self.ser.is_open:
            raise RuntimeError("Serial port is not connected")
        data = (command.strip().upper() + "\n").encode("utf-8")
        with self.write_lock:
            self.ser.write(data)
            self.ser.flush()

    def _reader_loop(self):
        while not self.stop_event.is_set() and self.ser and self.ser.is_open:
            try:
                raw = self.ser.readline()
                if not raw:
                    continue
                line = raw.decode("utf-8", errors="replace").strip()
                if line:
                    self.on_line_callback(line)
            except Exception as exc:
                self.on_status_callback(f"Serial read error: {exc}")
                break


class MeasurementParser:
    voltage_pattern = re.compile(r"^Voltage\s*=\s*,?\s*([-+]?[0-9]+(?:\.[0-9]+)?)$", re.IGNORECASE)
    align_voltage_pattern = re.compile(r"^AlignVoltage\s*=\s*,?\s*([-+]?[0-9]+(?:\.[0-9]+)?)$", re.IGNORECASE)
    humidity_pattern = re.compile(r"^Humidity\s*=\s*,?\s*([-+]?[0-9]+(?:\.[0-9]+)?)$", re.IGNORECASE)
    temp_pattern = re.compile(r"^Temperature\s*=\s*,?\s*([-+]?[0-9]+(?:\.[0-9]+)?)$", re.IGNORECASE)
    angle_pattern = re.compile(r"^Angle\s*=\s*,?\s*([-+]?[0-9]+(?:\.[0-9]+)?)$", re.IGNORECASE)
    sample_pattern = re.compile(r"^Sample\s*=\s*,?\s*([0-9]+)$", re.IGNORECASE)

    def __init__(self, max_points: int = MAX_POINTS):
        self.max_points = max_points
        self.state = ParsedState()
        self.samples: List[SamplePoint] = []
        self.pending_angle: Optional[float] = None
        self.pending_index: Optional[int] = None
        self.scan_completed = False
        self.scan_history = []
        self.scan_counter = 0

    @property
    def angles(self) -> List[float]:
        return [s.angle_deg for s in self.samples]

    @property
    def voltages(self) -> List[float]:
        return [s.voltage for s in self.samples]

    def feed_line(self, line: str):
        low = line.lower()

        if "measurement started" in low:
            self.state.mode = "Measuring"
            self.state.interrupted = False
            self.scan_completed = False
            self.clear_measurement(preserve_history=True)
        elif "measurement complete" in low:
            self.state.mode = "Standby"
            self.scan_completed = True
        elif "free mode active" in low:
            self.state.mode = "Free"
        elif "returning to nullpoint" in low:
            self.state.mode = "Homing"
        elif "nullpoint reached" in low or "already at nullpoint" in low:
            self.state.mode = "Standby"
        elif "mode=standby" in low:
            self.state.mode = "Standby"
        elif "mode=measuring" in low:
            self.state.mode = "Measuring"
        elif "mode=free" in low:
            self.state.mode = "Free"
        elif "mode=homing" in low:
            self.state.mode = "Homing"

        if "right end sensor triggered" in low or "measurement stopped" in low:
            self.state.interrupted = True

        hum_match = self.humidity_pattern.search(line)
        if hum_match:
            self.state.humidity_percent = float(hum_match.group(1))

        temp_match = self.temp_pattern.search(line)
        if temp_match:
            self.state.temperature_c = float(temp_match.group(1))

        align_match = self.align_voltage_pattern.search(line)
        if align_match:
            self.state.live_voltage_v = float(align_match.group(1))
            return

        if line.startswith("Config:"):
            return

        angle_match = self.angle_pattern.search(line)
        if angle_match:
            self.pending_angle = float(angle_match.group(1))

        sample_match = self.sample_pattern.search(line)
        if sample_match:
            self.pending_index = int(sample_match.group(1)) - 1

        volt_match = self.voltage_pattern.search(line)
        if volt_match and self.state.samples < self.max_points:
            voltage = float(volt_match.group(1))
            self.state.live_voltage_v = voltage
            index = self.pending_index if self.pending_index is not None else self.state.samples
            angle = self.pending_angle if self.pending_angle is not None else self.angle_for_sample(index, self.max_points)
            self.samples.append(SamplePoint(index=index, angle_deg=angle, voltage=voltage))
            self.state.samples += 1
            self.pending_angle = None
            self.pending_index = None

    @staticmethod
    def angle_for_sample(index: int, max_points: int = MAX_POINTS) -> float:
        if max_points <= 1:
            return 0.0
        return -90.0 + (180.0 * index / (max_points - 1))

    def archive_current_scan(self, label="Previous scan", diode_model="", colour="#ff5a1f"):
        if self.samples:
            self.scan_history.append(
                ScanRecord(
                    label=label,
                    diode_model=diode_model,
                    samples=[SamplePoint(index=s.index, angle_deg=s.angle_deg, voltage=s.voltage) for s in self.samples],
                    colour=colour,
                    interrupted=self.state.interrupted,
                )
            )
            if len(self.scan_history) > MAX_COMPARE_SCANS:
                self.scan_history = self.scan_history[-MAX_COMPARE_SCANS:]

    def clear_measurement(self, preserve_history: bool = True):
        self.samples = []
        self.state.samples = 0
        self.pending_angle = None
        self.pending_index = None
        self.scan_completed = False
        if not preserve_history:
            self.scan_history = []
            self.scan_counter = 0

    def ideal_cosine_curve(self, point_count: int = MAX_POINTS) -> Tuple[List[float], List[float]]:
        angles = []
        values = []
        if point_count <= 1:
            return [0.0], [1.0]
        for i in range(point_count):
            angle = self.angle_for_sample(i, point_count)
            angles.append(angle)
            values.append(max(0.0, math.cos(math.radians(angle))))
        return angles, values

    def _dark_offset(self, polarity_mode: str) -> float:
        if not self.samples:
            return 0.0
        edge_values = [sample.voltage for sample in self.samples if abs(sample.angle_deg) >= 85.0]
        if edge_values:
            return sum(edge_values) / len(edge_values)
        if polarity_mode == POLARITY_LOWER_IS_MORE:
            return max(sample.voltage for sample in self.samples)
        return min(sample.voltage for sample in self.samples)

    def _reference_voltage(self, polarity_mode: str) -> float:
        if not self.samples:
            return 1.0
        centre_values = [sample.voltage for sample in self.samples if abs(sample.angle_deg) <= 2.0]
        if centre_values:
            return sum(centre_values) / len(centre_values)
        if polarity_mode == POLARITY_LOWER_IS_MORE:
            return min(sample.voltage for sample in self.samples)
        return max(sample.voltage for sample in self.samples)

    def corrected_voltages(self, polarity_mode: str) -> List[float]:
        if not self.samples:
            return []
        dark = self._dark_offset(polarity_mode)
        corrected: List[float] = []
        for sample in self.samples:
            if polarity_mode == POLARITY_LOWER_IS_MORE:
                corrected.append(max(0.0, dark - sample.voltage))
            else:
                corrected.append(max(0.0, sample.voltage - dark))
        return corrected

    def normalised_voltages(self, polarity_mode: str, samples: Optional[List[SamplePoint]] = None) -> List[float]:
        source_samples = self.samples if samples is None else samples
        if not source_samples:
            return []
        original_samples = self.samples
        if samples is not None:
            self.samples = source_samples
        try:
            dark = self._dark_offset(polarity_mode)
            reference_voltage = self._reference_voltage(polarity_mode)
            if polarity_mode == POLARITY_LOWER_IS_MORE:
                reference = max(dark - reference_voltage, 1e-9)
            else:
                reference = max(reference_voltage - dark, 1e-9)
            return [max(0.0, min(1.2, corrected / reference)) for corrected in self.corrected_voltages(polarity_mode)]
        finally:
            if samples is not None:
                self.samples = original_samples

    def calculate_rmse(self, polarity_mode: str) -> Optional[float]:
        if not self.samples:
            return None
        measured = self.normalised_voltages(polarity_mode)
        errors = []
        for angle, value in zip(self.angles, measured):
            if abs(angle) <= 80.0:
                ideal = max(0.0, math.cos(math.radians(angle)))
                errors.append((value - ideal) ** 2)
        if not errors:
            return None
        return math.sqrt(sum(errors) / len(errors))

    def calculate_symmetry_error(self, polarity_mode: str) -> Optional[float]:
        if len(self.samples) < 3:
            return None
        measured = self.normalised_voltages(polarity_mode)
        by_angle = {round(a, 4): v for a, v in zip(self.angles, measured)}
        errors = []
        for angle in self.angles:
            if angle < 0:
                key = round(angle, 4)
                partner = round(-angle, 4)
                if key in by_angle and partner in by_angle:
                    errors.append(abs(by_angle[key] - by_angle[partner]))
        if not errors:
            return None
        return sum(errors) / len(errors)

    def raw_voltage_ticks(self, polarity_mode: str, samples: Optional[List[SamplePoint]] = None, norm_ticks: Optional[List[float]] = None) -> List[Tuple[float, float]]:
        source_samples = self.samples if samples is None else samples
        if not source_samples:
            return []
        norm_ticks = norm_ticks or [0.0, 0.2, 0.4, 0.6, 0.8, 1.0]
        original_samples = self.samples
        if samples is not None:
            self.samples = source_samples
        try:
            dark = self._dark_offset(polarity_mode)
            reference_voltage = self._reference_voltage(polarity_mode)
            if polarity_mode == POLARITY_LOWER_IS_MORE:
                scale = max(dark - reference_voltage, 1e-9)
                return [(tick, dark - tick * scale) for tick in norm_ticks]
            scale = max(reference_voltage - dark, 1e-9)
            return [(tick, dark + tick * scale) for tick in norm_ticks]
        finally:
            if samples is not None:
                self.samples = original_samples


    def draw_plot(self, ax, diode_model: str, polarity_mode: str, show_ideal: bool = True):
        if ax is None:
            return
        ax.clear()
        ax.set_title(f"Cosine response of {diode_model}" if diode_model else "Cosine response")
        ax.set_xlabel("Angle of Incidence (°)")
        ax.set_ylabel("Normalised Response (−)")
        ax.set_xlim(-100, 100)
        ax.set_ylim(0, 1.05)
        ax.grid(True, linestyle=(0, (1, 4)), linewidth=0.8)
        ax.axvline(0, linestyle="--", linewidth=1.0, color="#5fa3e3")

        if show_ideal:
            ideal_x, ideal_y = self.ideal_cosine_curve()
            ax.plot(ideal_x, ideal_y, label="Ideal Cosine (cos θ)", linewidth=2.0, color="#1f77b4")

        if self.samples:
            angles = [s.angle_deg for s in self.samples]
            norm = self.normalised_voltages(polarity_mode)
            ax.plot(angles, norm, marker="o", linewidth=1.2, markersize=3.2, color="#ff5a1f", label="Measured")

        if ax.lines:
            ax.legend(loc="upper left", fontsize=8)

    def save_plot(self, output_path: str, diode_model: str, polarity_mode: str, show_ideal: bool = True):
        if Figure is None:
            raise RuntimeError("matplotlib is not installed")
        fig = Figure(figsize=(10, 6), dpi=120)
        ax = fig.add_subplot(111)
        self.draw_plot(ax, diode_model, polarity_mode, show_ideal=show_ideal)
        fig.tight_layout()
        fig.savefig(output_path)

    def save_csv(self, output_path: str, diode_model: str, polarity_mode: str, notes: str = "", metadata: Optional[dict] = None):
        path = Path(output_path)
        metadata = metadata or {}

        scans = []
        for idx, rec in enumerate(self.scan_history, start=1):
            scans.append((rec.label or f"Scan {idx}", rec.samples))
        if self.samples:
            scans.append(("Current scan", self.samples))

        with path.open("w", newline="", encoding="utf-8") as handle:
            writer = csv.writer(handle)
            writer.writerow(["metadata", "value"])
            writer.writerow(["diode_model", diode_model])
            writer.writerow(["signal_polarity", polarity_mode])
            writer.writerow(["measurement_notes", notes])
            writer.writerow(["operator", metadata.get("operator", "")])
            writer.writerow(["diode_type", metadata.get("diode_type", "")])
            writer.writerow(["diffuser_used", metadata.get("diffuser_used", "")])
            writer.writerow(["bench_configuration", metadata.get("bench_configuration", "")])
            writer.writerow(["test_id", metadata.get("test_id", "")])
            writer.writerow(["firmware_version", metadata.get("firmware_version", "")])
            writer.writerow(["scan_duration_s", metadata.get("scan_duration_s", "")])
            writer.writerow(["scan_status", metadata.get("scan_status", "")])
            writer.writerow([])
            headers = []
            for label, _samples in scans:
                headers.extend([f"{label} angle_deg", f"{label} voltage_v", f"{label} normalised_v"])
            writer.writerow(headers)
            max_len = max((len(samps) for _, samps in scans), default=0)
            for row_idx in range(max_len):
                row = []
                for _label, samps in scans:
                    if row_idx < len(samps):
                        s = samps[row_idx]
                        norm_values = self.normalised_voltages(polarity_mode, samps)
                        norm = norm_values[row_idx] if row_idx < len(norm_values) else 0.0
                        row.extend([f"{s.angle_deg:.6f}", f"{s.voltage:.6f}", f"{norm:.6f}"])
                    else:
                        row.extend(["", "", ""])
                writer.writerow(row)


class BenchMainWindow(QMainWindow):
    def __init__(self):
        super().__init__()
        self.setWindowTitle(APP_TITLE)
        self.resize(1600, 920)
        self.setMinimumSize(1200, 700)

        self.setStyleSheet(APP_UI_STYLE)
        self._startup_geometry_applied = False
        self.resolution_status_label: Optional[QLabel] = None

        self.message_queue: "queue.Queue[Tuple[str, str]]" = queue.Queue()
        self.parser = MeasurementParser()
        self.worker = SerialWorker(self._queue_line, self._queue_status)
        self.connected = False
        self.control_buttons: dict[str, QPushButton] = {}
        self.alignment_history: Deque[float] = deque(maxlen=160)
        self.best_alignment_voltage: Optional[float] = None
        self.best_reset_pending = False
        self.last_saved_file: Optional[str] = None
        self.scan_start_monotonic: Optional[float] = None
        self.last_scan_duration_s: Optional[float] = None
        self.current_scan_status = "Ready"
        self.laser_manual_on = False
        self.position_home_state = "inactive"
        self.position_end_state = "inactive"
        self.home_stop_guard_armed = False
        self.scan_visibility = {}
        self.last_scan_finished_at = None
        self.scan_palette = ["#e41a1c", "#377eb8", "#4daf4a", "#984ea3", "#ff7f00", "#a65628", "#f781bf", "#17becf"]
        self.graph1_options = {"ideal": True, "current": True, "mirror": False, "grid": True, "error_band": False, "mode": "Normalised"}
        self.graph2_options = {"ideal": True, "current": True, "grid": True, "error_band": False, "mode": "Normalised"}
        self.current_scan_label = "Current scan"
        self._last_firmware_version = "--"
        self._last_board_name = "--"
        self._last_build_info = "--"
        self.scan_visibility = {}
        self.main_plot_splitter = None
        self.graph_column_splitter = None
        self.compare_scan_list_widget = None
        self.compare_panel_title_label = None
        self.rename_scan_button = None
        self.delete_scan_button = None
        self.graph1_export_png_check = None
        self.graph1_export_csv_check = None
        self.graph1_export_button = None
        self.graph1_export_frame = None
        self.graph1_export_toggle_button = None
        self.graph2_export_png_check = None
        self.graph2_export_csv_check = None
        self.graph2_export_avg_csv_check = None
        self.graph2_export_button = None
        self.graph2_export_frame = None
        self.graph2_export_toggle_button = None
        self.g1_ideal_check = None
        self.g1_current_check = None
        self.g1_mirror_check = None
        self.g1_grid_check = None
        self.g1_error_band_check = None
        self.g1_mode_combo = None
        self.g2_ideal_check = None
        self.g2_grid_check = None
        self.g2_error_band_check = None
        self.g2_mode_combo = None
        self.error_export_png_check = None
        self.error_export_csv_check = None
        self.error_export_button = None
        self.error_export_frame = None
        self.error_export_toggle_button = None
        self.clear_scans_button = None
        self.measurement_count_combo = None
        self.series_active = False
        self.series_total = 1
        self.series_index = 0
        self.pending_auto_restart = False
        self.pending_sequence_label = None
        self.current_scan_archived = False
        self.home_stop_guard_armed = False
        self.series_compare_mode = False
        self.best_reset_baseline: Optional[float] = None
        self.log_paused = False
        self.laser_manual_on = False

        self.port_combo: Optional[QComboBox] = None
        self.connect_button: Optional[QPushButton] = None
        self.controls_status_label: Optional[QLabel] = None
        self.status_label: Optional[QLabel] = None
        self.device_model_label: Optional[QLabel] = None
        self.device_port_label: Optional[QLabel] = None
        self.device_hwid_label: Optional[QLabel] = None
        self.device_manufacturer_label: Optional[QLabel] = None
        self.device_firmware_label: Optional[QLabel] = None
        self.device_connected_at_label: Optional[QLabel] = None
        self._connected_port_info = None
        self._connected_at_text = "--"
        self.mode_label: Optional[QLabel] = None
        self.temp_label: Optional[QLabel] = None
        self.temp_bar: Optional[QProgressBar] = None
        self.humidity_label: Optional[QLabel] = None
        self.humidity_bar: Optional[QProgressBar] = None
        self.samples_label: Optional[QLabel] = None
        self.progress_bar: Optional[QProgressBar] = None
        self.scan_progress_label: Optional[QLabel] = None
        self.rmse_label: Optional[QLabel] = None
        self.symmetry_label: Optional[QLabel] = None
        self.alignment_scale_label: Optional[QLabel] = None
        self.alignment_bar: Optional[QProgressBar] = None
        self.export_preview_label: Optional[QLabel] = None
        self.measurement_setup_summary_label: Optional[QLabel] = None
        self.measurement_setup_button: Optional[QPushButton] = None
        self.measurement_setup_dialog: Optional[QDialog] = None
        self.measurement_setup_form_widget: Optional[QWidget] = None
        self.measurement_setup_form_layout = None
        self.motion_control_summary_label: Optional[QLabel] = None
        self.motion_control_button: Optional[QPushButton] = None
        self.motion_control_dialog: Optional[QDialog] = None
        self.motion_control_form_widget: Optional[QWidget] = None
        self.motion_control_form_layout = None
        self.output_folder_edit: Optional[QLineEdit] = None
        self.diode_model_edit: Optional[QLineEdit] = None
        self.notes_edit: Optional[QLineEdit] = None
        self.scan_speed_spin: Optional[QSpinBox] = None
        self.return_speed_spin: Optional[QSpinBox] = None
        self.polarity_combo: Optional[QComboBox] = None
        self.log_box: Optional[QPlainTextEdit] = None
        self.canvas: Optional[FigureCanvas] = None
        self.figure: Optional[Figure] = None
        self.ax = None
        self.alignment_canvas: Optional[FigureCanvas] = None
        self.alignment_figure: Optional[Figure] = None
        self.alignment_ax = None
        self.compare_canvas = None
        self.trend_live_checkbox = None
        self.compare_figure = None
        self.compare_ax = None
        self.error_canvas = None
        self.main_plot_splitter = None
        self.content_splitter = None
        self.left_content_panel = None
        self._main_right_ax = None

        self._build_ui()
        self._apply_compact_top_layout()
        self._polish_button_styles()
        self._refresh_ports()

        self.timer = QTimer(self)
        self.timer.timeout.connect(self._process_queue)
        self.timer.start(100)
        QTimer.singleShot(250, self._maybe_show_update_popup)

    def _settings_path(self) -> Path:
        return Path(__file__).resolve().parent / SETTINGS_FILE

    def _load_json_settings_data(self) -> dict:
        path = self._settings_path()
        if not path.exists():
            return {}
        try:
            return json.loads(path.read_text(encoding="utf-8"))
        except Exception:
            return {}

    def _save_json_settings_data(self, data: dict) -> None:
        path = self._settings_path()
        try:
            path.write_text(json.dumps(data, indent=2, ensure_ascii=False), encoding="utf-8")
        except Exception:
            pass


    def _set_export_panel_visibility(self, panel_name: str, visible: bool):
        frame = getattr(self, f"{panel_name}_export_frame", None)
        button = getattr(self, f"{panel_name}_export_toggle_button", None)
        if frame is not None:
            frame.setVisible(visible)
        if button is not None:
            button.setText("Hide export" if visible else "Export")

    def _toggle_export_panel(self, panel_name: str):
        button = getattr(self, f"{panel_name}_export_toggle_button", None)
        if button is not None:
            self._show_export_popup(panel_name, button)

    def _show_export_popup(self, panel_name: str, anchor_button: QPushButton):
        dialog = QDialog(self, Qt.Popup)
        dialog.setWindowTitle("Export")
        layout = QVBoxLayout(dialog)
        layout.setContentsMargins(8, 8, 8, 8)
        layout.setSpacing(5)
        title = QLabel("Export")
        title.setStyleSheet("font-size: 11px; font-weight: 600;")
        layout.addWidget(title)

        def add_check(label_text: str, checked: bool):
            cb = QCheckBox(label_text)
            cb.setChecked(checked)
            layout.addWidget(cb)
            return cb

        if panel_name == "graph1":
            png_cb = add_check("Graph (png)", self.graph1_export_png_check.isChecked())
            csv_cb = add_check("Scan Data (csv)", self.graph1_export_csv_check.isChecked())
            action = QPushButton("Export scan")
            action.clicked.connect(lambda: (self.graph1_export_png_check.setChecked(png_cb.isChecked()), self.graph1_export_csv_check.setChecked(csv_cb.isChecked()), dialog.accept(), self._export_graph1_selected()))
        elif panel_name == "graph2":
            png_cb = add_check("Graph (png)", self.graph2_export_png_check.isChecked())
            csv_cb = add_check("Scan Data (csv)*", self.graph2_export_csv_check.isChecked())
            avg_cb = add_check("Average Scan Data (csv)", self.graph2_export_avg_csv_check.isChecked())
            note = QLabel("*all displayed data")
            note.setStyleSheet("font-size: 9px; color: #666666;")
            layout.addWidget(note)
            action = QPushButton("Export scan")
            action.clicked.connect(lambda: (self.graph2_export_png_check.setChecked(png_cb.isChecked()), self.graph2_export_csv_check.setChecked(csv_cb.isChecked()), self.graph2_export_avg_csv_check.setChecked(avg_cb.isChecked()), dialog.accept(), self._export_graph2_selected()))
        else:
            png_cb = add_check("Graph (png)", self.error_export_png_check.isChecked())
            csv_cb = add_check("Scan Data (csv)", self.error_export_csv_check.isChecked())
            action = QPushButton("Export scan")
            action.clicked.connect(lambda: (self.error_export_png_check.setChecked(png_cb.isChecked()), self.error_export_csv_check.setChecked(csv_cb.isChecked()), dialog.accept(), self._export_error_selected()))

        action.setMinimumHeight(24)
        layout.addWidget(action)
        dialog.adjustSize()
        popup_size = dialog.sizeHint()
        anchor_top_left = anchor_button.mapToGlobal(anchor_button.rect().topLeft())
        pos = anchor_top_left - QPoint(0, popup_size.height() + 4)
        screen = QApplication.screenAt(anchor_top_left)
        if screen is not None:
            available = screen.availableGeometry()
            if pos.y() < available.top():
                pos = anchor_button.mapToGlobal(anchor_button.rect().bottomLeft()) + QPoint(0, 4)
            if pos.x() + popup_size.width() > available.right():
                pos.setX(max(available.left(), available.right() - popup_size.width()))
            if pos.x() < available.left():
                pos.setX(available.left())
        dialog.move(pos)
        dialog.exec()

    def _update_measurement_setup_summary(self):
        if self.measurement_setup_summary_label is None:
            return
        diode_model = self.diode_model_edit.text().strip() if self.diode_model_edit is not None else ""
        diode_type = self.diode_type_edit.text().strip() if hasattr(self, "diode_type_edit") and self.diode_type_edit is not None else ""
        diffuser_used = self.diffuser_edit.text().strip() if hasattr(self, "diffuser_edit") and self.diffuser_edit is not None else ""
        bench_config = self.bench_config_edit.text().strip() if hasattr(self, "bench_config_edit") and self.bench_config_edit is not None else ""
        test_id = self.test_id_edit.text().strip() if hasattr(self, "test_id_edit") and self.test_id_edit is not None else ""
        operator = self.operator_edit.text().strip() if hasattr(self, "operator_edit") and self.operator_edit is not None else ""
        output_folder = self.output_folder_edit.text().strip() if self.output_folder_edit is not None else ""
        summary_html = (
            "<table cellspacing='0' cellpadding='0' style='font-size:11px; color:#333333;'>"
            f"<tr><td style='padding-right:12px;'><b>Diode Model:</b> {diode_model or '--'}</td><td><b>Bench Config:</b> {bench_config or '--'}</td></tr>"
            f"<tr><td style='padding-right:12px;'><b>Diode Type:</b> {diode_type or '--'}</td><td><b>Test ID:</b> {test_id or '--'}</td></tr>"
            f"<tr><td style='padding-right:12px;'><b>Diffuser Used:</b> {diffuser_used or '--'}</td><td><b>Operator:</b> {operator or '--'}</td></tr>"
            "</table>"
        )
        self.measurement_setup_summary_label.setText(summary_html)
        self.measurement_setup_summary_label.setToolTip(output_folder or "Measurement setup summary")

    def _update_motion_control_summary(self):
        if self.motion_control_summary_label is None:
            return
        scan_speed = self.scan_speed_spin.value() if self.scan_speed_spin is not None else 0
        return_speed = self.return_speed_spin.value() if self.return_speed_spin is not None else 0
        polarity = self.polarity_combo.currentText().strip() if self.polarity_combo is not None else "--"
        summary_html = (
            f"<b>Scan:</b> {scan_speed} µs    <b>Return:</b> {return_speed} µs<br>"
            f"<b>Polarity:</b> {polarity or '--'}"
        )
        self.motion_control_summary_label.setText(summary_html)
        self.motion_control_summary_label.setToolTip("Motion control summary")

    def _close_measurement_setup_dialog(self):
        if self.measurement_setup_dialog is not None:
            self.measurement_setup_dialog.accept()

    def _show_measurement_setup_dialog(self):
        if self.measurement_setup_form_widget is None:
            return
        dialog = QDialog(self)
        dialog.setWindowTitle("Measurement Setup")
        dialog.setMinimumWidth(820)
        layout = QVBoxLayout(dialog)
        layout.setContentsMargins(10, 10, 10, 10)
        layout.setSpacing(8)
        self.measurement_setup_form_widget.setParent(dialog)
        self.measurement_setup_form_widget.setVisible(True)
        layout.addWidget(self.measurement_setup_form_widget)
        button_box = QDialogButtonBox(QDialogButtonBox.Close)
        button_box.rejected.connect(dialog.reject)
        layout.addWidget(button_box)
        self.measurement_setup_dialog = dialog
        dialog.exec()
        if self.measurement_setup_form_layout is not None:
            self.measurement_setup_form_widget.setParent(self)
            self.measurement_setup_form_layout.addWidget(self.measurement_setup_form_widget)
            self.measurement_setup_form_widget.setVisible(False)
        self.measurement_setup_dialog = None
        self._update_measurement_setup_summary()
        self._update_motion_control_summary()

    def _show_motion_control_dialog(self):
        if self.motion_control_form_widget is None:
            return
        dialog = QDialog(self)
        dialog.setWindowTitle("Motion Control")
        dialog.setMinimumWidth(640)
        layout = QVBoxLayout(dialog)
        layout.setContentsMargins(10, 10, 10, 10)
        layout.setSpacing(8)
        self.motion_control_form_widget.setParent(dialog)
        self.motion_control_form_widget.setVisible(True)
        layout.addWidget(self.motion_control_form_widget)
        button_box = QDialogButtonBox(QDialogButtonBox.Close)
        button_box.rejected.connect(dialog.reject)
        layout.addWidget(button_box)
        self.motion_control_dialog = dialog
        dialog.exec()
        if self.motion_control_form_layout is not None:
            self.motion_control_form_widget.setParent(self)
            self.motion_control_form_layout.addWidget(self.motion_control_form_widget)
            self.motion_control_form_widget.setVisible(False)
        self.motion_control_dialog = None
        self._update_motion_control_summary()

    def _apply_compact_top_layout(self):
        compact_font = QFont()
        compact_font.setPointSize(9)
        for group in self.findChildren(QGroupBox):
            group.setFont(compact_font)
            layout = group.layout()
            if layout is not None:
                layout.setContentsMargins(4, 4, 4, 4)
                layout.setSpacing(3)
                if hasattr(layout, "setVerticalSpacing"):
                    layout.setVerticalSpacing(2)
                if hasattr(layout, "setHorizontalSpacing"):
                    layout.setHorizontalSpacing(6)
        for button in self.findChildren(QPushButton):
            if button.text() in {"Start Scan", "Stop Scan", "Free Measure"}:
                button.setMinimumHeight(25)
            elif button.text() in {"Edit setup", "Export", "Hide export", "Hide Test Bench Settings", "Show Test Bench Settings"}:
                button.setMinimumHeight(21)
            else:
                button.setMinimumHeight(21)
        for edit in self.findChildren(QLineEdit):
            edit.setMinimumHeight(21)
        for edit in self.findChildren(QComboBox):
            edit.setMinimumHeight(21)
        for edit in self.findChildren(QSpinBox):
            edit.setMinimumHeight(21)

    def _polish_button_styles(self):
        radius = "4px"
        default_border = "#9a9a9a"
        for button in self.findChildren(QPushButton):
            existing = button.styleSheet() or ""
            if "border-radius" not in existing:
                existing = (existing + f" border-radius: {radius};").strip()
            if "background-color" not in existing and "border:" not in existing:
                existing = (existing + f" border: 1px solid {default_border};").strip()
            elif "background-color" not in existing and "border:" in existing and "#d" not in existing:
                pass
            button.setStyleSheet(existing)

        uniform = [
            getattr(self, "free_measure_button", None),
            getattr(self, "stop_live_button", None),
            getattr(self, "reset_best_button", None),
        ]
        styles = {
            self.free_measure_button: BUTTON_ACTIVE_STYLE,
            self.stop_live_button: BUTTON_DISABLED_STYLE,
            self.reset_best_button: RESET_BEST_BUTTON_STYLE,
        }
        for btn in uniform:
            if btn is not None:
                btn.setMinimumHeight(24)
                btn.setMaximumWidth(96)
                btn.setMinimumWidth(96)
                btn.setStyleSheet(styles[btn])

        pressed_feedback_buttons = [
            getattr(self, "refresh_button", None),
            getattr(self, "connect_button", None),
            getattr(self, "measurement_setup_button", None),
            getattr(self, "motion_control_button", None),
            getattr(self, "clear_plot_button", None),
            getattr(self, "clear_session_button", None),
            getattr(self, "browse_output_folder_button", None),
            getattr(self, "motion_preset_slow_button", None),
            getattr(self, "motion_preset_standard_button", None),
            getattr(self, "motion_preset_fast_button", None),
            getattr(self, "motion_read_speeds_button", None),
            getattr(self, "motion_apply_speeds_button", None),
            getattr(self, "motion_default_speeds_button", None),
        ]
        for btn in pressed_feedback_buttons:
            if btn is not None:
                btn.setStyleSheet(BUTTON_PRESS_FEEDBACK_STYLE)


    def _make_panel_frame(self) -> QFrame:
        frame = QFrame()
        frame.setFrameShape(QFrame.StyledPanel)
        frame.setLineWidth(1)
        return frame

    def _build_ui(self):
        root = QWidget()
        self.setCentralWidget(root)

        menubar = self.menuBar()
        file_menu = menubar.addMenu("File")
        file_menu.addAction("Save CSV", self._save_csv)
        file_menu.addAction("Save PNG", self._save_png)
        file_menu.addAction("Export report set", self._export_report_set)
        file_menu.addSeparator()
        file_menu.addAction("Exit", self.close)

        tools_menu = menubar.addMenu("Tools")
        tools_menu.addAction("Read speeds", self._request_speed_settings)
        tools_menu.addAction("Apply speeds", self._apply_speed_settings)
        tools_menu.addAction("Show log", self._show_log_panel)
        tools_menu.addAction("Clear log", self._clear_log)
        tools_menu.addAction("Clear session", self._clear_session)
        tools_menu.addAction("Settings", self._show_settings_dialog)
        tools_menu.addAction("Reset all settings", self._reset_all_settings)

        help_menu = menubar.addMenu("Help")
        help_menu.addAction("How to use", self._show_help_dialog)
        help_menu.addAction(f"What's new (V{APP_VERSION})", self._show_whats_new_dialog)
        help_menu.addAction("Full changelog", self._open_full_changelog)
        help_menu.addAction("About", self._show_about_dialog)

        main_layout = QVBoxLayout(root)
        main_layout.setContentsMargins(3, 0, 3, 3)
        main_layout.setSpacing(1)
        menubar.setStyleSheet("QMenuBar { padding-top: 0px; padding-bottom: 0px; margin: 0px; } QMenuBar::item { padding: 3px 8px; margin: 0px; }")

        header_container = QWidget()
        header_container.setStyleSheet("background-color: #f7f7f7;")
        header_container.setMinimumHeight(30)
        header_row = QHBoxLayout(header_container)
        header_row.setContentsMargins(8, 2, 8, 2)
        header_row.setSpacing(2)
        header_row.setAlignment(Qt.AlignVCenter)
        title_spacer_left = QWidget()
        title_spacer_left.setSizePolicy(QSizePolicy.Expanding, QSizePolicy.Fixed)
        header_row.addWidget(title_spacer_left, 1)
        title_label = QLabel(APP_TITLE)
        title_label.setTextInteractionFlags(Qt.TextSelectableByMouse)
        title_label.setAlignment(Qt.AlignCenter | Qt.AlignVCenter)
        title_label.setMinimumHeight(28)
        title_label.setStyleSheet("font-size: 20px; font-weight: 700; padding: 0px; margin: 0px;")
        header_row.addWidget(title_label, 0, Qt.AlignVCenter)
        title_spacer_right = QWidget()
        title_spacer_right.setSizePolicy(QSizePolicy.Expanding, QSizePolicy.Fixed)
        header_row.addWidget(title_spacer_right, 1)
        self.header_version_label = QLabel(f"V{APP_VERSION}")
        self.header_version_label.setTextInteractionFlags(Qt.TextSelectableByMouse)
        self.header_version_label.setAlignment(Qt.AlignLeft | Qt.AlignVCenter)
        self.header_version_label.setMinimumHeight(28)
        self.header_version_label.setStyleSheet("font-size: 11px; color: #555555; font-weight: 600; padding-right: 2px; margin: 0px;")
        header_row.addWidget(self.header_version_label, 0, Qt.AlignLeft | Qt.AlignVCenter)
        main_layout.addWidget(header_container, 0)

        self.operator_edit = QLineEdit()
        self.diode_type_edit = QLineEdit()
        self.diffuser_edit = QLineEdit()
        self.bench_config_edit = QLineEdit()
        self.test_id_edit = QLineEdit()
        self.diode_model_edit = QLineEdit()
        self.diode_model_edit.textChanged.connect(self._on_metadata_changed)
        self.export_preview_label = QLabel(self._suggest_export_basename())
        self.export_preview_label.setTextInteractionFlags(Qt.TextSelectableByMouse)
        self.notes_edit = QLineEdit()
        self.notes_edit.setPlaceholderText("Optional notes for this scan")
        self.notes_edit.textChanged.connect(self._on_metadata_changed)
        self.output_folder_edit = QLineEdit(str(Path.cwd()))
        self.output_folder_edit.textChanged.connect(self._on_metadata_changed)
        connection_device_group = QGroupBox("Connection and Device")
        connection_device_group.setStyleSheet(WINDOW_GROUPBOX_STYLE)
        connection_device_group.setSizePolicy(QSizePolicy.Preferred, QSizePolicy.Maximum)
        connection_device_layout = QVBoxLayout(connection_device_group)
        connection_device_layout.setContentsMargins(8, 8, 8, 8)
        connection_device_layout.setSpacing(6)

        connection_row = QGridLayout()
        connection_row.setHorizontalSpacing(6)
        connection_row.setVerticalSpacing(4)
        connection_row.addWidget(QLabel("Serial port"), 0, 0)
        self.port_combo = QComboBox()
        self.port_combo.setToolTip("Select the COM port used by the test bench controller")
        self.port_combo.setMinimumWidth(150)
        connection_row.addWidget(self.port_combo, 0, 1)
        self.refresh_button = QPushButton("Refresh")
        refresh_button = self.refresh_button
        refresh_button.setMinimumHeight(24)
        refresh_button.clicked.connect(self._refresh_ports)
        connection_row.addWidget(refresh_button, 0, 2)
        self.connect_button = QPushButton("Connect")
        self.connect_button.setToolTip("Connect or disconnect the software from the test bench controller")
        self.connect_button.setMinimumHeight(24)
        self.connect_button.clicked.connect(self._toggle_connection)
        connection_row.addWidget(self.connect_button, 0, 3)
        self.status_label = QLabel("○ Disconnected")
        self.status_label.setTextInteractionFlags(Qt.TextSelectableByMouse)
        self.status_label.setStyleSheet("color: #666666;")
        connection_row.addWidget(self.status_label, 1, 0, 1, 4)
        connection_device_layout.addLayout(connection_row)

        device_grid = QGridLayout()
        device_grid.setHorizontalSpacing(8)
        device_grid.setVerticalSpacing(3)
        device_grid.addWidget(QLabel("Model"), 0, 0)
        self.device_model_label = QLabel("--")
        self.device_model_label.setTextInteractionFlags(Qt.TextSelectableByMouse)
        self.device_model_label.setWordWrap(True)
        device_grid.addWidget(self.device_model_label, 0, 1)
        device_grid.addWidget(QLabel("Port"), 1, 0)
        self.device_port_label = QLabel("--")
        self.device_port_label.setTextInteractionFlags(Qt.TextSelectableByMouse)
        self.device_port_label.setWordWrap(True)
        device_grid.addWidget(self.device_port_label, 1, 1)
        device_grid.addWidget(QLabel("Manufacturer"), 2, 0)
        self.device_manufacturer_label = QLabel("--")
        self.device_manufacturer_label.setTextInteractionFlags(Qt.TextSelectableByMouse)
        self.device_manufacturer_label.setWordWrap(True)
        device_grid.addWidget(self.device_manufacturer_label, 2, 1)
        device_grid.addWidget(QLabel("Firmware"), 3, 0)
        self.device_firmware_label = QLabel("--")
        self.device_firmware_label.setTextInteractionFlags(Qt.TextSelectableByMouse)
        self.device_firmware_label.setWordWrap(True)
        device_grid.addWidget(self.device_firmware_label, 3, 1)
        device_grid.addWidget(QLabel("Connected at"), 4, 0)
        self.device_connected_at_label = QLabel("--")
        self.device_connected_at_label.setTextInteractionFlags(Qt.TextSelectableByMouse)
        self.device_connected_at_label.setWordWrap(True)
        device_grid.addWidget(self.device_connected_at_label, 4, 1)
        device_grid.addWidget(QLabel("Hardware ID"), 5, 0)
        self.device_hwid_label = QLabel("--")
        self.device_hwid_label.setTextInteractionFlags(Qt.TextSelectableByMouse)
        self.device_hwid_label.setWordWrap(True)
        device_grid.addWidget(self.device_hwid_label, 5, 1)
        connection_device_layout.addLayout(device_grid)

        self.motion_control_form_container = QWidget(self)
        self.motion_control_form_container.hide()
        self.motion_control_form_layout = QVBoxLayout(self.motion_control_form_container)
        self.motion_control_form_layout.setContentsMargins(0, 0, 0, 0)
        self.motion_control_form_layout.setSpacing(0)

        self.motion_control_form_widget = QWidget()
        motion_layout = QGridLayout(self.motion_control_form_widget)
        motion_layout.setContentsMargins(4, 4, 4, 4)
        motion_layout.setHorizontalSpacing(8)
        motion_layout.setVerticalSpacing(4)
        motion_layout.addWidget(QLabel("Scan speed (microseconds)"), 0, 0)
        self.scan_speed_spin = QSpinBox()
        self.scan_speed_spin.setToolTip("Delay between motion steps during scan. Higher value means slower scan")
        self.scan_speed_spin.setRange(200, 20000)
        self.scan_speed_spin.setSingleStep(50)
        self.scan_speed_spin.setValue(600)
        self.scan_speed_spin.valueChanged.connect(self._update_motion_control_summary)
        motion_layout.addWidget(self.scan_speed_spin, 0, 1)
        motion_layout.addWidget(QLabel("Return speed (microseconds)"), 1, 0)
        self.return_speed_spin = QSpinBox()
        self.return_speed_spin.setToolTip("Delay between motion steps when returning to home position")
        self.return_speed_spin.setRange(100, 20000)
        self.return_speed_spin.setSingleStep(50)
        self.return_speed_spin.setValue(300)
        self.return_speed_spin.valueChanged.connect(self._update_motion_control_summary)
        motion_layout.addWidget(self.return_speed_spin, 1, 1)
        motion_layout.addWidget(QLabel("Signal polarity"), 2, 0)
        self.polarity_combo = QComboBox()
        self.polarity_combo.setToolTip("Choose how the detector signal should be interpreted during normalisation")
        self.polarity_combo.addItems([POLARITY_HIGHER_IS_MORE, POLARITY_LOWER_IS_MORE])
        self.polarity_combo.setCurrentText(POLARITY_LOWER_IS_MORE)
        self.polarity_combo.currentTextChanged.connect(self._on_polarity_changed)
        self.polarity_combo.currentTextChanged.connect(self._update_motion_control_summary)
        motion_layout.addWidget(self.polarity_combo, 2, 1)
        preset_row = QHBoxLayout()
        self.motion_preset_slow_button = QPushButton("Slow preset")
        slow_btn = self.motion_preset_slow_button
        slow_btn.clicked.connect(lambda: self._apply_speed_preset(13333, 4000, "Slow"))
        preset_row.addWidget(slow_btn)
        self.motion_preset_standard_button = QPushButton("Standard preset")
        std_btn = self.motion_preset_standard_button
        std_btn.clicked.connect(lambda: self._apply_speed_preset(8000, 3000, "Standard"))
        preset_row.addWidget(std_btn)
        self.motion_preset_fast_button = QPushButton("Fast preset")
        fast_btn = self.motion_preset_fast_button
        fast_btn.clicked.connect(lambda: self._apply_speed_preset(3000, 1200, "Fast"))
        preset_row.addWidget(fast_btn)
        motion_layout.addLayout(preset_row, 3, 0, 1, 2)
        action_row = QHBoxLayout()
        self.motion_read_speeds_button = QPushButton("Read speeds")
        query_speed_button = self.motion_read_speeds_button
        query_speed_button.clicked.connect(self._request_speed_settings)
        action_row.addWidget(query_speed_button)
        self.motion_apply_speeds_button = QPushButton("Apply speeds")
        apply_speed_button = self.motion_apply_speeds_button
        apply_speed_button.clicked.connect(self._apply_speed_settings)
        action_row.addWidget(apply_speed_button)
        self.motion_default_speeds_button = QPushButton("Default speeds")
        default_speed_button = self.motion_default_speeds_button
        default_speed_button.clicked.connect(lambda: self._apply_speed_preset(8000, 3000, "Default"))
        action_row.addWidget(default_speed_button)
        motion_layout.addLayout(action_row, 4, 0, 1, 2)
        self.motion_control_form_layout.addWidget(self.motion_control_form_widget)
        self.motion_control_form_widget.setVisible(False)

        controls_group = QGroupBox("Controls")
        controls_group.setStyleSheet(WINDOW_GROUPBOX_STYLE)
        controls_layout = QGridLayout(controls_group)
        controls_layout.setContentsMargins(6, 4, 6, 4)
        controls_layout.setHorizontalSpacing(4)
        controls_layout.setVerticalSpacing(3)

        def _make_section_title(text_value):
            label = QLabel(text_value)
            label.setAlignment(Qt.AlignLeft | Qt.AlignVCenter)
            label.setStyleSheet("font-size: 11px; font-weight: 600; color: #555555;")
            return label

        scanning_frame = self._make_panel_frame()
        scanning_frame.setStyleSheet(WINDOW_FRAME_STYLE)
        scanning_layout = QGridLayout(scanning_frame)
        scanning_layout.setContentsMargins(6, 6, 6, 6)
        scanning_layout.setHorizontalSpacing(5)
        scanning_layout.setVerticalSpacing(2)
        scanning_layout.addWidget(_make_section_title("Scanning control"), 0, 0, 1, 3)

        start_btn = QPushButton("Start Scan")
        start_btn.setMinimumHeight(22)
        start_btn.setStyleSheet(BUTTON_ACTIVE_STYLE)
        start_btn.clicked.connect(self._start_scan_sequence)
        self.control_buttons["START"] = start_btn
        scanning_layout.addWidget(start_btn, 1, 0)

        stop_btn = QPushButton("Stop Scan")
        stop_btn.setMinimumHeight(22)
        stop_btn.setStyleSheet(BUTTON_ACTIVE_STYLE)
        stop_btn.clicked.connect(lambda checked=False, c="STOP": self._send_command(c))
        self.control_buttons["STOP"] = stop_btn
        scanning_layout.addWidget(stop_btn, 1, 2)

        count_holder = QWidget()
        count_layout = QHBoxLayout(count_holder)
        count_layout.setContentsMargins(0, 0, 0, 0)
        count_layout.setSpacing(4)
        scans_label = QLabel("scans:")
        scans_label.setAlignment(Qt.AlignLeft | Qt.AlignVCenter)
        scans_label.setStyleSheet("font-size: 11px; font-weight: 600; color: #555555;")
        count_layout.addWidget(scans_label)
        self.measurement_count_combo = QComboBox()
        self.measurement_count_combo.setToolTip("Choose how many scans should run automatically in sequence, up to 8")
        self.measurement_count_combo.addItems([str(i) for i in range(1, 9)])
        self.measurement_count_combo.setCurrentText("1")
        self.measurement_count_combo.setMinimumWidth(68)
        self.measurement_count_combo.setMaximumWidth(76)
        count_layout.addWidget(self.measurement_count_combo)
        scanning_layout.addWidget(count_holder, 1, 1, alignment=Qt.AlignCenter)

        positioning_frame = self._make_panel_frame()
        positioning_frame.setStyleSheet(WINDOW_FRAME_STYLE)
        positioning_layout = QGridLayout(positioning_frame)
        positioning_layout.setContentsMargins(6, 6, 6, 6)
        positioning_layout.setHorizontalSpacing(4)
        positioning_layout.setVerticalSpacing(2)
        positioning_layout.addWidget(_make_section_title("Positioning and Laser"), 0, 0, 1, 4)

        home_btn = QPushButton("Home position")
        home_btn.setMinimumHeight(18)
        home_btn.setStyleSheet(BUTTON_NEUTRAL_STYLE + " padding: 0 8px;")
        home_btn.clicked.connect(lambda checked=False, c="HOME": self._send_command(c))
        self.control_buttons["HOME"] = home_btn
        positioning_layout.addWidget(home_btn, 1, 0)

        end_btn = QPushButton("End position")
        end_btn.setMinimumHeight(18)
        end_btn.setStyleSheet(BUTTON_NEUTRAL_STYLE + " padding: 0 8px;")
        end_btn.setToolTip("Rotate the arm to the far end position. Requires firmware support")
        end_btn.clicked.connect(lambda checked=False: self._send_command("GO END"))
        self.control_buttons["GOEND"] = end_btn
        positioning_layout.addWidget(end_btn, 1, 1)

        self.laser_toggle_button = QPushButton("Laser On")
        self.laser_toggle_button.setMinimumHeight(18)
        self.laser_toggle_button.setStyleSheet(BUTTON_NEUTRAL_STYLE + " padding: 0 8px;")
        self.laser_toggle_button.setToolTip("Turn the laser on or off while in standby")
        self.laser_toggle_button.clicked.connect(self._toggle_laser_manual)
        self.control_buttons["LASERON"] = self.laser_toggle_button
        positioning_layout.addWidget(self.laser_toggle_button, 1, 2)

        status_btn = QPushButton("Status")
        status_btn.setMinimumHeight(18)
        status_btn.setStyleSheet(BUTTON_NEUTRAL_STYLE + " padding: 0 8px;")
        status_btn.clicked.connect(lambda checked=False, c="STATUS": self._send_command(c))
        self.control_buttons["STATUS"] = status_btn
        positioning_layout.addWidget(status_btn, 1, 3)

        motion_compact_frame = self._make_panel_frame()
        motion_compact_frame.setStyleSheet(WINDOW_FRAME_STYLE)
        motion_compact_layout = QGridLayout(motion_compact_frame)
        motion_compact_layout.setContentsMargins(6, 6, 6, 6)
        motion_compact_layout.setHorizontalSpacing(4)
        motion_compact_layout.setVerticalSpacing(2)
        motion_compact_layout.addWidget(_make_section_title("Motion control"), 0, 0, 1, 2)
        self.motion_control_summary_label = QLabel("<b>Scan:</b> --    <b>Return:</b> --<br><b>Polarity:</b> --")
        self.motion_control_summary_label.setWordWrap(True)
        self.motion_control_summary_label.setStyleSheet("font-size: 10px; line-height: 1.2; color: #333333;")
        self.motion_control_summary_label.setTextInteractionFlags(Qt.TextSelectableByMouse)
        motion_compact_layout.addWidget(self.motion_control_summary_label, 1, 0)
        self.motion_control_button = QPushButton("Edit control")
        self.motion_control_button.setMinimumHeight(22)
        self.motion_control_button.setMinimumWidth(104)
        self.motion_control_button.setMaximumWidth(180)
        self.motion_control_button.setStyleSheet("font-weight: 600; padding: 1px 10px;")
        self.motion_control_button.clicked.connect(self._show_motion_control_dialog)
        motion_compact_layout.addWidget(self.motion_control_button, 1, 1, Qt.AlignTop | Qt.AlignRight)

        controls_layout.addWidget(scanning_frame, 1, 0)
        controls_layout.addWidget(positioning_frame, 2, 0)
        controls_layout.addWidget(motion_compact_frame, 3, 0)

        session_actions_frame = self._make_panel_frame()
        session_actions_frame.setStyleSheet(WINDOW_FRAME_STYLE)
        session_actions_layout = QHBoxLayout(session_actions_frame)
        session_actions_layout.setContentsMargins(6, 6, 6, 6)
        session_actions_layout.setSpacing(6)
        session_actions_title = _make_section_title("Session actions")
        session_actions_layout.addWidget(session_actions_title, 0)
        session_actions_layout.addStretch(1)
        self.clear_plot_button = QPushButton("Clear Plot")
        self.clear_plot_button.setMinimumHeight(20)
        self.clear_plot_button.setStyleSheet("background-color: #f3f4f6; border: 1px solid #c4cad2; color: #374151; font-weight: 600; padding: 1px 10px;")
        self.clear_plot_button.clicked.connect(self._clear_measurement)
        session_actions_layout.addWidget(self.clear_plot_button)
        self.clear_session_button = QPushButton("Clear Session")
        self.clear_session_button.setMinimumHeight(20)
        self.clear_session_button.setStyleSheet("background-color: #f3f4f6; border: 1px solid #c4cad2; color: #374151; font-weight: 600; padding: 1px 10px;")
        self.clear_session_button.clicked.connect(self._clear_session)
        session_actions_layout.addWidget(self.clear_session_button)
        controls_layout.addWidget(session_actions_frame, 4, 0)

        self.controls_status_label = QLabel("")
        self.controls_status_label.setTextInteractionFlags(Qt.TextSelectableByMouse)
        self.controls_status_label.setAlignment(Qt.AlignLeft | Qt.AlignVCenter)
        self.controls_status_label.setStyleSheet("font-size: 10px; color: #555555; padding-top: 1px;")
        controls_layout.addWidget(self.controls_status_label, 5, 0)
        measurement_setup_group = QGroupBox("Measurement Setup")
        measurement_setup_group.setStyleSheet(WINDOW_GROUPBOX_STYLE)
        measurement_setup_group.setSizePolicy(QSizePolicy.Preferred, QSizePolicy.Maximum)
        measurement_setup_group_layout = QVBoxLayout(measurement_setup_group)
        measurement_setup_group_layout.setContentsMargins(8, 8, 8, 8)
        measurement_setup_group_layout.setSpacing(8)

        summary_row = QHBoxLayout()
        summary_row.setContentsMargins(0, 0, 0, 0)
        summary_row.setSpacing(10)
        self.measurement_setup_summary_label = QLabel("<table cellspacing='2' cellpadding='3' style='font-size:11px; color:#333333;'><tr><td style='padding-right:28px; padding-bottom:2px;'><b>Diode Model:</b> --</td><td style='padding-bottom:2px;'><b>Bench Config:</b> --</td></tr><tr><td style='padding-right:28px; padding-bottom:2px;'><b>Diode Type:</b> --</td><td style='padding-bottom:2px;'><b>Test ID:</b> --</td></tr><tr><td style='padding-right:28px;'><b>Diffuser Used:</b> --</td><td><b>Operator:</b> --</td></tr></table>")
        self.measurement_setup_summary_label.setWordWrap(True)
        self.measurement_setup_summary_label.setStyleSheet("font-size: 11px; line-height: 1.35; color: #333333;")
        self.measurement_setup_summary_label.setTextInteractionFlags(Qt.TextSelectableByMouse)
        summary_row.addWidget(self.measurement_setup_summary_label, 1)
        self.measurement_setup_button = QPushButton("Edit setup")
        self.measurement_setup_button.setMinimumHeight(22)
        self.measurement_setup_button.setMinimumWidth(104)
        self.measurement_setup_button.setStyleSheet("font-weight: 600; padding: 1px 8px;")
        self.measurement_setup_button.clicked.connect(self._show_measurement_setup_dialog)
        summary_row.addWidget(self.measurement_setup_button, 0, Qt.AlignTop)
        measurement_setup_group_layout.addLayout(summary_row)

        self.measurement_setup_form_layout = QVBoxLayout()
        self.measurement_setup_form_layout.setContentsMargins(0, 0, 0, 0)
        self.measurement_setup_form_layout.setSpacing(0)
        measurement_setup_group_layout.addLayout(self.measurement_setup_form_layout)

        self.measurement_setup_form_widget = QWidget()
        measurement_setup_layout = QGridLayout(self.measurement_setup_form_widget)
        measurement_setup_layout.setContentsMargins(4, 4, 4, 4)
        measurement_setup_layout.setHorizontalSpacing(8)
        measurement_setup_layout.setVerticalSpacing(4)
        measurement_setup_layout.addWidget(QLabel("Diode model"), 0, 0)
        measurement_setup_layout.addWidget(self.diode_model_edit, 0, 1)
        measurement_setup_layout.addWidget(QLabel("Operator"), 0, 2)
        self.operator_edit.textChanged.connect(self._on_metadata_changed)
        measurement_setup_layout.addWidget(self.operator_edit, 0, 3)
        measurement_setup_layout.addWidget(QLabel("Diode type"), 1, 0)
        self.diode_type_edit.textChanged.connect(self._on_metadata_changed)
        measurement_setup_layout.addWidget(self.diode_type_edit, 1, 1)
        measurement_setup_layout.addWidget(QLabel("Diffuser used"), 1, 2)
        self.diffuser_edit.textChanged.connect(self._on_metadata_changed)
        measurement_setup_layout.addWidget(self.diffuser_edit, 1, 3)
        measurement_setup_layout.addWidget(QLabel("Bench config"), 2, 0)
        self.bench_config_edit.textChanged.connect(self._on_metadata_changed)
        measurement_setup_layout.addWidget(self.bench_config_edit, 2, 1)
        measurement_setup_layout.addWidget(QLabel("Test ID"), 2, 2)
        self.test_id_edit.textChanged.connect(self._on_metadata_changed)
        measurement_setup_layout.addWidget(self.test_id_edit, 2, 3)
        measurement_setup_layout.addWidget(QLabel("Export filename"), 3, 0)
        measurement_setup_layout.addWidget(self.export_preview_label, 3, 1)
        measurement_setup_layout.addWidget(QLabel("Measurement notes"), 4, 0)
        measurement_setup_layout.addWidget(self.notes_edit, 4, 1, 1, 3)
        measurement_setup_layout.addWidget(QLabel("Output folder"), 5, 0)
        folder_row = QHBoxLayout()
        folder_row.addWidget(self.output_folder_edit)
        self.browse_output_folder_button = QPushButton("Browse")
        browse_button = self.browse_output_folder_button
        browse_button.setMinimumHeight(24)
        browse_button.clicked.connect(self._browse_output_folder)
        folder_row.addWidget(browse_button)
        measurement_setup_layout.addLayout(folder_row, 5, 1, 1, 3)
        self.measurement_setup_form_layout.addWidget(self.measurement_setup_form_widget)
        self.measurement_setup_form_widget.setVisible(False)
        content_splitter = QSplitter(Qt.Horizontal)
        self.content_splitter = content_splitter
        content_splitter.setHandleWidth(6)
        main_layout.addWidget(content_splitter, 1)

        graphs_panel = self._make_panel_frame()
        graphs_layout = QHBoxLayout(graphs_panel)
        graphs_layout.setContentsMargins(4, 4, 4, 4)
        graph_splitter = QSplitter(Qt.Horizontal)
        self.graph_column_splitter = graph_splitter
        graph_splitter.setHandleWidth(4)
        graphs_layout.addWidget(graph_splitter)

        if FigureCanvas is None or Figure is None:
            placeholder = QLabel("matplotlib Qt backend is not available. Install matplotlib to show the graphs.")
            placeholder.setWordWrap(True)
            placeholder.setSizePolicy(QSizePolicy.Expanding, QSizePolicy.Expanding)
            graph_splitter.addWidget(placeholder)
        else:
            left_plot_column = QWidget()
            left_plot_layout = QVBoxLayout(left_plot_column)
            left_plot_layout.setContentsMargins(0, 0, 0, 0)
            left_plot_layout.setSpacing(2)

            self.main_plot_splitter = QSplitter(Qt.Vertical)
            self.main_plot_splitter.setChildrenCollapsible(True)
            self.main_plot_splitter.setHandleWidth(6)

            top_plot_panel = QWidget()
            top_plot_layout = QHBoxLayout(top_plot_panel)
            top_plot_layout.setContentsMargins(0, 0, 0, 0)
            top_plot_layout.setSpacing(2)

            self.figure = Figure(figsize=(9.6, 5.2), dpi=100)
            self.ax = self.figure.add_subplot(111)
            self.canvas = FigureCanvas(self.figure)
            top_plot_layout.addWidget(self.canvas, 1)

            graph1_side_panel = QWidget()
            graph1_side_panel.setMinimumWidth(165)
            graph1_side_panel.setMaximumWidth(165)
            graph1_side_layout = QVBoxLayout(graph1_side_panel)
            graph1_side_layout.setContentsMargins(0, 0, 8, 2)
            graph1_side_layout.setSpacing(4)

            graph1_settings_frame = self._make_panel_frame()
            graph1_settings_layout = QVBoxLayout(graph1_settings_frame)
            graph1_settings_layout.setContentsMargins(8, 8, 8, 8)
            graph1_settings_layout.setSpacing(4)
            graph1_settings_label = QLabel("Graph settings")
            graph1_settings_label.setAlignment(Qt.AlignLeft | Qt.AlignVCenter)
            graph1_settings_label.setStyleSheet("font-size: 11px; font-weight: 600;")
            graph1_settings_layout.addWidget(graph1_settings_label)
            self.g1_ideal_check = QCheckBox("Ideal cosine")
            self.g1_ideal_check.setToolTip("Show or hide the ideal cosine reference curve on Graph 1: Cosine Response")
            self.g1_ideal_check.setChecked(True)
            self.g1_ideal_check.toggled.connect(self._sync_graph_options_from_controls)
            graph1_settings_layout.addWidget(self.g1_ideal_check)
            self.g1_current_check = QCheckBox(self.current_scan_label)
            self.g1_current_check.setToolTip("Show or hide the current scan on Graph 1: Cosine Response")
            self.g1_current_check.setChecked(True)
            self.g1_current_check.toggled.connect(self._sync_graph_options_from_controls)
            graph1_settings_layout.addWidget(self.g1_current_check)
            self.g1_mirror_check = QCheckBox("Mirrored Curve")
            self.g1_mirror_check.setToolTip("Overlay the mirrored version of the current scan to assess symmetry")
            self.g1_mirror_check.setChecked(False)
            self.g1_mirror_check.toggled.connect(self._sync_graph_options_from_controls)
            graph1_settings_layout.addWidget(self.g1_mirror_check)
            self.g1_grid_check = QCheckBox("Grid")
            self.g1_grid_check.setChecked(True)
            self.g1_grid_check.toggled.connect(self._sync_graph_options_from_controls)
            graph1_settings_layout.addWidget(self.g1_grid_check)
            self.g1_error_band_check = QCheckBox("Show Error Band")
            self.g1_error_band_check.setToolTip("Highlight the difference between the measured response and the ideal cosine on Graph 1: Cosine Response")
            self.g1_error_band_check.setChecked(False)
            self.g1_error_band_check.toggled.connect(self._sync_graph_options_from_controls)
            graph1_settings_layout.addWidget(self.g1_error_band_check)
            graph1_mode_label = QLabel("Normalise mode")
            graph1_mode_label.setAlignment(Qt.AlignLeft | Qt.AlignVCenter)
            graph1_mode_label.setStyleSheet("font-size: 10px; color: #555555;")
            graph1_settings_layout.addWidget(graph1_mode_label)
            self.g1_mode_combo = QComboBox()
            self.g1_mode_combo.setToolTip("Switch Graph 1: Cosine Response between normalised response and raw detector voltage")
            self.g1_mode_combo.addItems(["Normalised", "Raw voltage"])
            self.g1_mode_combo.currentTextChanged.connect(self._sync_graph_options_from_controls)
            graph1_settings_layout.addWidget(self.g1_mode_combo)
            graph1_side_layout.addWidget(graph1_settings_frame, 0)
            graph1_side_layout.addStretch(1)
            self.graph1_export_toggle_button = QPushButton("Export")
            self.graph1_export_toggle_button.setMinimumHeight(24)
            self.graph1_export_toggle_button.setMinimumWidth(80)
            self.graph1_export_toggle_button.setMaximumWidth(80)
            self.graph1_export_toggle_button.setStyleSheet("font-weight: 600;")
            self.graph1_export_toggle_button.clicked.connect(lambda: self._show_export_popup("graph1", self.graph1_export_toggle_button))
            graph1_side_layout.addWidget(self.graph1_export_toggle_button, 0, Qt.AlignRight | Qt.AlignBottom)


            self.graph1_export_frame = self._make_panel_frame()
            self.graph1_export_frame.setSizePolicy(QSizePolicy.Preferred, QSizePolicy.Maximum)
            graph1_export_layout = QVBoxLayout(self.graph1_export_frame)
            graph1_export_layout.setContentsMargins(8, 8, 8, 8)
            graph1_export_layout.setSpacing(4)
            graph1_export_label = QLabel("Export")
            graph1_export_label.setAlignment(Qt.AlignLeft | Qt.AlignVCenter)
            graph1_export_label.setStyleSheet("font-size: 11px; font-weight: 600;")
            graph1_export_layout.addWidget(graph1_export_label)

            self.graph1_export_png_check = QCheckBox("Graph (png)")
            self.graph1_export_png_check.setChecked(True)
            graph1_export_layout.addWidget(self.graph1_export_png_check)
            self.graph1_export_csv_check = QCheckBox("Scan Data (csv)")
            self.graph1_export_csv_check.setChecked(False)
            graph1_export_layout.addWidget(self.graph1_export_csv_check)
            self.graph1_export_button = QPushButton("Export scan")
            self.graph1_export_button.setToolTip("Export the current Graph 1: Cosine Response view using the selected export options")
            self.graph1_export_button.setMinimumHeight(24)
            self.graph1_export_button.clicked.connect(self._export_graph1_selected)
            graph1_export_layout.addWidget(self.graph1_export_button)
            self.graph1_export_frame.hide()
            self._set_export_panel_visibility("graph1", False)

            top_plot_layout.addWidget(graph1_side_panel)
            self.main_plot_splitter.addWidget(top_plot_panel)

            bottom_plot_panel = QWidget()
            bottom_plot_layout = QHBoxLayout(bottom_plot_panel)
            bottom_plot_layout.setContentsMargins(0, 0, 0, 0)
            bottom_plot_layout.setSpacing(2)

            self.compare_figure = Figure(figsize=(9.6, 2.2), dpi=100)
            self.compare_ax = self.compare_figure.add_subplot(111)
            self.compare_canvas = FigureCanvas(self.compare_figure)
            bottom_plot_layout.addWidget(self.compare_canvas, 1)

            compare_side_panel = QWidget()
            compare_side_panel.setMinimumWidth(165)
            compare_side_panel.setMaximumWidth(165)
            compare_side_layout = QVBoxLayout(compare_side_panel)
            compare_side_layout.setContentsMargins(0, 0, 8, 2)
            compare_side_layout.setSpacing(4)

            graph2_settings_frame = self._make_panel_frame()
            graph2_settings_layout = QVBoxLayout(graph2_settings_frame)
            graph2_settings_layout.setContentsMargins(8, 8, 8, 8)
            graph2_settings_layout.setSpacing(4)
            graph2_settings_label = QLabel("Graph settings")
            graph2_settings_label.setAlignment(Qt.AlignLeft | Qt.AlignVCenter)
            graph2_settings_label.setStyleSheet("font-size: 11px; font-weight: 600;")
            graph2_settings_layout.addWidget(graph2_settings_label)
            self.g2_ideal_check = QCheckBox("Ideal cosine")
            self.g2_ideal_check.setToolTip("Show or hide the ideal cosine reference curve on Graph 2: Cosine Response Comparison")
            self.g2_ideal_check.setChecked(True)
            self.g2_ideal_check.toggled.connect(self._sync_graph_options_from_controls)
            graph2_settings_layout.addWidget(self.g2_ideal_check)
            self.g2_grid_check = QCheckBox("Grid")
            self.g2_grid_check.setChecked(True)
            self.g2_grid_check.toggled.connect(self._sync_graph_options_from_controls)
            graph2_settings_layout.addWidget(self.g2_grid_check)
            self.g2_error_band_check = QCheckBox("Show Error Band")
            self.g2_error_band_check.setToolTip("Highlight the difference between displayed scans and the ideal cosine on Graph 2: Cosine Response Comparison")
            self.g2_error_band_check.setChecked(False)
            self.g2_error_band_check.toggled.connect(self._sync_graph_options_from_controls)
            graph2_settings_layout.addWidget(self.g2_error_band_check)
            graph2_mode_label = QLabel("Normalise mode")
            graph2_mode_label.setAlignment(Qt.AlignLeft | Qt.AlignVCenter)
            graph2_mode_label.setStyleSheet("font-size: 10px; color: #555555;")
            graph2_settings_layout.addWidget(graph2_mode_label)
            self.g2_mode_combo = QComboBox()
            self.g2_mode_combo.setToolTip("Switch Graph 2: Cosine Response Comparison between normalised response and raw detector voltage")
            self.g2_mode_combo.addItems(["Normalised", "Raw voltage"])
            self.g2_mode_combo.currentTextChanged.connect(self._sync_graph_options_from_controls)
            graph2_settings_layout.addWidget(self.g2_mode_combo)
            graph2_settings_frame.setSizePolicy(QSizePolicy.Preferred, QSizePolicy.Maximum)
            compare_side_layout.addWidget(graph2_settings_frame, 0)

            scan_manager_frame = self._make_panel_frame()
            scan_manager_frame.setMinimumHeight(120)
            scan_manager_frame.setSizePolicy(QSizePolicy.Preferred, QSizePolicy.Expanding)
            scan_manager_layout = QVBoxLayout(scan_manager_frame)
            scan_manager_layout.setContentsMargins(0, 0, 0, 0)
            scan_manager_layout.setSpacing(4)
            self.compare_panel_title_label = QLabel("Scans")
            self.compare_panel_title_label.setAlignment(Qt.AlignLeft | Qt.AlignVCenter)
            self.compare_panel_title_label.setStyleSheet("font-size: 11px; font-weight: 600;")
            scan_manager_layout.addWidget(self.compare_panel_title_label)

            self.compare_scan_list_widget = QListWidget()
            self.compare_scan_list_widget.setSizePolicy(QSizePolicy.Expanding, QSizePolicy.Expanding)
            self.compare_scan_list_widget.setVerticalScrollMode(QAbstractItemView.ScrollPerPixel)
            self.compare_scan_list_widget.setMinimumWidth(0)
            self.compare_scan_list_widget.setMaximumWidth(16777215)
            self.compare_scan_list_widget.setFrameShape(QFrame.NoFrame)
            self.compare_scan_list_widget.setVerticalScrollBarPolicy(Qt.ScrollBarAlwaysOn)
            self.compare_scan_list_widget.setUniformItemSizes(True)
            self.compare_scan_list_widget.setHorizontalScrollBarPolicy(Qt.ScrollBarAlwaysOff)
            self.compare_scan_list_widget.setContentsMargins(0, 0, 0, 0)
            self.compare_scan_list_widget.setViewportMargins(0, 0, 0, 0)
            self.compare_scan_list_widget.setStyleSheet("""
                QListWidget {
                    padding: 0px;
                    margin: 0px;
                    border: none;
                }
                QScrollBar:vertical {
                    width: 10px;
                    margin: 0px;
                    padding: 0px;
                }
                QScrollBar::add-line:vertical,
                QScrollBar::sub-line:vertical {
                    height: 0px;
                }
            """)
            self.compare_scan_list_widget.itemChanged.connect(self._on_scan_visibility_changed)
            self.compare_scan_list_widget.itemDoubleClicked.connect(self._rename_scan_from_item)
            self.compare_scan_list_widget.itemSelectionChanged.connect(self._update_scan_manager_buttons)
            scan_manager_layout.addWidget(self.compare_scan_list_widget, 1)

            compare_button_row_1 = QHBoxLayout()
            compare_button_row_1.setSpacing(4)
            self.rename_scan_button = QPushButton("Edit")
            self.rename_scan_button.setToolTip("Rename the selected scan and change its colour")
            self.rename_scan_button.setMinimumHeight(24)
            self.rename_scan_button.clicked.connect(self._rename_selected_scan)
            compare_button_row_1.addWidget(self.rename_scan_button)
            self.delete_scan_button = QPushButton("Delete")
            self.delete_scan_button.setToolTip("Delete the selected stored scan from Graph 2: Cosine Response Comparison")
            self.delete_scan_button.setMinimumHeight(24)
            self.delete_scan_button.clicked.connect(self._delete_selected_scan)
            compare_button_row_1.addWidget(self.delete_scan_button)
            scan_manager_layout.addLayout(compare_button_row_1)

            compare_button_row_2 = QHBoxLayout()
            compare_button_row_2.setSpacing(4)
            self.clear_scans_button = QPushButton("Clear")
            self.clear_scans_button.setToolTip("Clear all stored scans from the Graph 2: Cosine Response Comparison scan list")
            self.clear_scans_button.setMinimumHeight(24)
            self.clear_scans_button.clicked.connect(self._clear_stored_scans)
            compare_button_row_2.addWidget(self.clear_scans_button)
            scan_manager_layout.addLayout(compare_button_row_2)
            compare_side_layout.addWidget(scan_manager_frame, 1)
            compare_side_layout.addSpacing(2)
            self.graph2_export_toggle_button = QPushButton("Export")
            self.graph2_export_toggle_button.setMinimumHeight(24)
            self.graph2_export_toggle_button.setMinimumWidth(80)
            self.graph2_export_toggle_button.setMaximumWidth(80)
            self.graph2_export_toggle_button.setStyleSheet("font-weight: 600;")
            self.graph2_export_toggle_button.clicked.connect(lambda: self._show_export_popup("graph2", self.graph2_export_toggle_button))


            self.graph2_export_frame = self._make_panel_frame()
            compare_export_layout = QVBoxLayout(self.graph2_export_frame)
            compare_export_layout.setContentsMargins(8, 8, 8, 8)
            compare_export_layout.setSpacing(4)
            compare_export_label = QLabel("Export")
            compare_export_label.setAlignment(Qt.AlignLeft | Qt.AlignVCenter)
            compare_export_label.setStyleSheet("font-size: 11px; font-weight: 600;")
            compare_export_layout.addWidget(compare_export_label)
            self.graph2_export_png_check = QCheckBox("Graph (png)")
            self.graph2_export_png_check.setChecked(True)
            compare_export_layout.addWidget(self.graph2_export_png_check)
            self.graph2_export_csv_check = QCheckBox("Scan Data (csv)*")
            self.graph2_export_csv_check.setChecked(False)
            compare_export_layout.addWidget(self.graph2_export_csv_check)
            self.graph2_export_avg_csv_check = QCheckBox("Average Scan Data (csv)")
            self.graph2_export_avg_csv_check.setChecked(False)
            compare_export_layout.addWidget(self.graph2_export_avg_csv_check)
            self.graph2_export_note_label = QLabel("*all displayed data")
            self.graph2_export_note_label.setAlignment(Qt.AlignLeft | Qt.AlignTop)
            self.graph2_export_note_label.setStyleSheet("font-size: 9px; color: #666666;")
            compare_export_layout.addWidget(self.graph2_export_note_label)
            self.graph2_export_button = QPushButton("Export scan")
            self.graph2_export_button.setToolTip("Export the current Graph 2: Cosine Response Comparison view using only the scans that are currently displayed")
            self.graph2_export_button.setMinimumHeight(24)
            self.graph2_export_button.clicked.connect(self._export_graph2_selected)
            compare_export_layout.addWidget(self.graph2_export_button)
            self.graph2_export_frame.setSizePolicy(QSizePolicy.Preferred, QSizePolicy.Maximum)
            compare_side_layout.addWidget(self.graph2_export_toggle_button, 0, Qt.AlignRight | Qt.AlignBottom)
            self.graph2_export_frame.hide()
            self._set_export_panel_visibility("graph2", False)

            bottom_plot_layout.addWidget(compare_side_panel)
            self.main_plot_splitter.addWidget(bottom_plot_panel)

            error_plot_panel = QWidget()
            error_plot_layout = QHBoxLayout(error_plot_panel)
            error_plot_layout.setContentsMargins(0, 0, 0, 0)
            error_plot_layout.setSpacing(2)

            self.error_figure = Figure(figsize=(9.6, 2.0), dpi=100)
            self.error_ax = self.error_figure.add_subplot(111)
            self.error_canvas = FigureCanvas(self.error_figure)
            error_plot_layout.addWidget(self.error_canvas, 1)

            self.error_side_panel = QWidget()
            self.error_side_panel.setMinimumWidth(165)
            self.error_side_panel.setMaximumWidth(165)
            error_side_layout = QVBoxLayout(self.error_side_panel)
            error_side_layout.setContentsMargins(0, 0, 8, 2)
            error_side_layout.setSpacing(4)
            self.error_status_label = QLabel("")
            self.error_status_label.setTextInteractionFlags(Qt.TextSelectableByMouse)
            self.error_status_label.setWordWrap(True)
            self.error_status_label.setAlignment(Qt.AlignTop | Qt.AlignLeft)
            self.error_status_label.setVisible(False)
            self.error_status_label.setStyleSheet("font-size: 10px; color: #555555;")
            error_side_layout.addWidget(self.error_status_label)
            self.error_export_toggle_button = QPushButton("Export")
            self.error_export_toggle_button.setMinimumHeight(24)
            self.error_export_toggle_button.setMinimumWidth(80)
            self.error_export_toggle_button.setMaximumWidth(80)
            self.error_export_toggle_button.setStyleSheet("font-weight: 600;")
            self.error_export_toggle_button.clicked.connect(lambda: self._show_export_popup("error", self.error_export_toggle_button))
            error_side_layout.addStretch(1)
            error_side_layout.addSpacing(2)
            error_side_layout.addWidget(self.error_export_toggle_button, 0, Qt.AlignRight | Qt.AlignBottom)

            self.error_export_frame = self._make_panel_frame()
            self.error_export_frame.setSizePolicy(QSizePolicy.Preferred, QSizePolicy.Maximum)
            error_export_layout = QVBoxLayout(self.error_export_frame)
            error_export_layout.setContentsMargins(8, 8, 8, 8)
            error_export_layout.setSpacing(4)
            error_export_label = QLabel("Export")
            error_export_label.setAlignment(Qt.AlignLeft | Qt.AlignVCenter)
            error_export_label.setStyleSheet("font-size: 11px; font-weight: 600;")
            error_export_layout.addWidget(error_export_label)
            self.error_export_png_check = QCheckBox("Graph (png)")
            self.error_export_png_check.setChecked(True)
            error_export_layout.addWidget(self.error_export_png_check)
            self.error_export_csv_check = QCheckBox("Scan Data (csv)")
            self.error_export_csv_check.setChecked(False)
            error_export_layout.addWidget(self.error_export_csv_check)
            self.error_export_button = QPushButton("Export scan")
            self.error_export_button.setToolTip("Export the current Cosine Error graph or its data")
            self.error_export_button.setMinimumHeight(24)
            self.error_export_button.clicked.connect(self._export_error_selected)
            error_export_layout.addWidget(self.error_export_button)
            self.error_export_frame.hide()
            self._set_export_panel_visibility("error", False)
            error_plot_layout.addWidget(self.error_side_panel)

            self.main_plot_splitter.addWidget(error_plot_panel)
            self.main_plot_splitter.setSizes([400, 500, 170])

            left_plot_layout.addWidget(self.main_plot_splitter, 1)

            graph_splitter.addWidget(left_plot_column)

            right_graph_column = QWidget()
            right_graph_layout = QVBoxLayout(right_graph_column)
            right_graph_layout.setContentsMargins(0, 0, 0, 0)
            right_graph_layout.setSpacing(6)

            status_panel = self._make_panel_frame()
            status_panel.setStyleSheet(WINDOW_FRAME_STYLE)
            status_outer = QVBoxLayout(status_panel)
            status_outer.setContentsMargins(10, 10, 10, 10)
            status_outer.setSpacing(8)

            status_outer.addWidget(connection_device_group)
            status_outer.addWidget(measurement_setup_group)
            status_outer.addWidget(controls_group)

            measurement_group = QGroupBox("Measurement")
            measurement_group.setStyleSheet(WINDOW_GROUPBOX_STYLE)
            measurement_outer = QVBoxLayout(measurement_group)
            measurement_outer.setContentsMargins(8, 8, 8, 8)
            measurement_outer.setSpacing(5)

            measurement_header = QHBoxLayout()
            measurement_header.setContentsMargins(0, 0, 0, 0)
            measurement_header.setSpacing(6)
            self.mode_label = QLabel("Mode: IDLE")
            self.mode_label.setTextInteractionFlags(Qt.TextSelectableByMouse)
            self.mode_label.setWordWrap(True)
            self.mode_label.setStyleSheet("font-weight: 700; font-size: 13px; color: #111111;")
            self.mode_label.setSizePolicy(QSizePolicy.Expanding, QSizePolicy.Preferred)
            controls_layout.addWidget(self.mode_label, 0, 0, Qt.AlignLeft | Qt.AlignTop)
            self.samples_label = QLabel("Status: Ready")
            self.samples_label.setAlignment(Qt.AlignLeft | Qt.AlignVCenter)
            self.samples_label.setTextInteractionFlags(Qt.TextSelectableByMouse)
            self.samples_label.setWordWrap(False)
            self.samples_label.setStyleSheet("font-weight: 700; font-size: 13px; color: #111111;")
            self.samples_label.setSizePolicy(QSizePolicy.MinimumExpanding, QSizePolicy.Preferred)
            self.samples_label.setMinimumWidth(180)

            measurement_header.addWidget(self.samples_label, 0, Qt.AlignLeft | Qt.AlignVCenter)
            measurement_header.addStretch(1)
            measurement_outer.addLayout(measurement_header)

            progress_row = QHBoxLayout()
            progress_row.setContentsMargins(0, 0, 0, 0)
            progress_row.setSpacing(6)
            self.progress_bar = QProgressBar()
            self.progress_bar.setRange(0, MAX_POINTS)
            self.progress_bar.setValue(0)
            self.progress_bar.setTextVisible(False)
            self.progress_bar.setMinimumHeight(9)
            self.progress_bar.setMaximumHeight(9)
            self.progress_bar.setSizePolicy(QSizePolicy.Expanding, QSizePolicy.Fixed)
            self.progress_bar.setStyleSheet("""
                QProgressBar {
                    border: 1px solid #bfc7cf;
                    border-radius: 4px;
                    background: #f4f6f8;
                }
                QProgressBar::chunk {
                    border-radius: 4px;
                    background-color: #2f7ed8;
                }
            """)
            self.progress_value_label = QLabel(f"0/{MAX_POINTS}")
            self.progress_value_label.setAlignment(Qt.AlignLeft | Qt.AlignVCenter)
            self.progress_value_label.setStyleSheet("font-weight: 600; font-size: 12px; color: #111111;")
            self.progress_value_label.setMinimumWidth(54)
            progress_row.addWidget(self.progress_bar, 1)
            progress_row.addWidget(self.progress_value_label, 0)
            measurement_outer.addLayout(progress_row)

            environment_layout = QHBoxLayout()
            environment_layout.setContentsMargins(0, 2, 0, 0)
            environment_layout.setSpacing(10)

            temp_block = QVBoxLayout()
            temp_block.setContentsMargins(0, 0, 0, 0)
            temp_block.setSpacing(1)
            self.temp_label = QLabel("Temperature: --")
            self.temp_label.setTextInteractionFlags(Qt.TextSelectableByMouse)
            self.temp_label.setWordWrap(True)
            self.temp_label.setStyleSheet("font-weight: 600; font-size: 12px; color: #111111;")
            self.temp_gauge = EnvironmentGauge(0, 50, 15, 35, "°C", "#ffb74d")
            self.temp_gauge.setMinimumHeight(34)
            self.temp_gauge.setMaximumHeight(38)
            temp_block.addWidget(self.temp_label, 0, Qt.AlignLeft | Qt.AlignBottom)
            temp_block.addWidget(self.temp_gauge, 0, Qt.AlignTop)
            environment_layout.addLayout(temp_block, 1)

            humidity_block = QVBoxLayout()
            humidity_block.setContentsMargins(0, 0, 0, 0)
            humidity_block.setSpacing(1)
            self.humidity_label = QLabel("Humidity: --")
            self.humidity_label.setTextInteractionFlags(Qt.TextSelectableByMouse)
            self.humidity_label.setWordWrap(True)
            self.humidity_label.setStyleSheet("font-weight: 600; font-size: 12px; color: #111111;")
            self.humidity_gauge = EnvironmentGauge(0, 100, 20, 60, "%", "#64b5f6")
            self.humidity_gauge.setMinimumHeight(34)
            self.humidity_gauge.setMaximumHeight(38)
            humidity_block.addWidget(self.humidity_label, 0, Qt.AlignLeft | Qt.AlignBottom)
            humidity_block.addWidget(self.humidity_gauge, 0, Qt.AlignTop)
            environment_layout.addLayout(humidity_block, 1)

            measurement_outer.addLayout(environment_layout)

            measurement_divider = QFrame()
            measurement_divider.setFrameShape(QFrame.HLine)
            measurement_divider.setFrameShadow(QFrame.Plain)
            measurement_divider.setStyleSheet("color: #d7d7d7;")
            measurement_outer.addWidget(measurement_divider)

            scan_info_divider = QFrame()
            scan_info_divider.setFrameShape(QFrame.HLine)
            scan_info_divider.setFrameShadow(QFrame.Plain)
            scan_info_divider.setStyleSheet("color: #e0e0e0;")
            measurement_outer.addWidget(scan_info_divider)

            self.scan_info_title_label = QLabel("Scan info")
            self.scan_info_title_label.setStyleSheet("font-size: 11px; font-weight: 600; color: #7a7a7a; padding-top: 3px;")
            measurement_outer.addWidget(self.scan_info_title_label)

            scan_info_grid = QGridLayout()
            scan_info_grid.setContentsMargins(0, 0, 0, 0)
            scan_info_grid.setHorizontalSpacing(18)
            scan_info_grid.setVerticalSpacing(4)
            scan_info_grid.setColumnStretch(0, 1)
            scan_info_grid.setColumnStretch(1, 1)

            self.rmse_label = QLabel("RMSE (≤ 80°): --")
            self.rmse_label.setTextInteractionFlags(Qt.TextSelectableByMouse)
            self.rmse_label.setWordWrap(True)
            self.rmse_label.setStyleSheet("font-size: 12px; color: #111111;")
            scan_info_grid.addWidget(self.rmse_label, 0, 0)

            self.centre_value_label = QLabel("Response at 0° (normalised): --")
            self.centre_value_label.setTextInteractionFlags(Qt.TextSelectableByMouse)
            self.centre_value_label.setWordWrap(True)
            self.centre_value_label.setStyleSheet("font-size: 12px; color: #111111;")
            scan_info_grid.addWidget(self.centre_value_label, 0, 1)

            self.symmetry_label = QLabel("Symmetry error (|+θ − −θ| mean): --")
            self.symmetry_label.setTextInteractionFlags(Qt.TextSelectableByMouse)
            self.symmetry_label.setWordWrap(True)
            self.symmetry_label.setStyleSheet("font-size: 12px; color: #111111;")
            scan_info_grid.addWidget(self.symmetry_label, 1, 0)

            self.peak_angle_label = QLabel("Peak offset from 0° (max response): --")
            self.peak_angle_label.setTextInteractionFlags(Qt.TextSelectableByMouse)
            self.peak_angle_label.setWordWrap(True)
            self.peak_angle_label.setStyleSheet("font-size: 12px; color: #111111;")
            scan_info_grid.addWidget(self.peak_angle_label, 1, 1)

            self.scan_finished_label = QLabel("Finished: --")
            self.scan_finished_label.setTextInteractionFlags(Qt.TextSelectableByMouse)
            self.scan_finished_label.setWordWrap(True)
            self.scan_finished_label.setStyleSheet("font-size: 12px; color: #111111;")
            scan_info_grid.addWidget(self.scan_finished_label, 2, 0)

            self.scan_duration_label = QLabel("Duration: --")
            self.scan_duration_label.setTextInteractionFlags(Qt.TextSelectableByMouse)
            self.scan_duration_label.setWordWrap(True)
            self.scan_duration_label.setStyleSheet("font-size: 12px; color: #111111;")
            scan_info_grid.addWidget(self.scan_duration_label, 2, 1)
            measurement_outer.addLayout(scan_info_grid)

            self.scan_summary_label = QLabel("--")
            self.scan_summary_label.setWordWrap(True)
            self.scan_summary_label.setTextInteractionFlags(Qt.TextSelectableByMouse)
            self.scan_summary_label.setStyleSheet("padding-top: 2px; color: #222222; font-size: 12px;")
            measurement_outer.addWidget(self.scan_summary_label)

            self.scan_summary_secondary_label = QLabel("")
            self.scan_summary_secondary_label.setWordWrap(True)
            self.scan_summary_secondary_label.setTextInteractionFlags(Qt.TextSelectableByMouse)
            self.scan_summary_secondary_label.setStyleSheet("color: #222222; font-size: 12px; padding-top: 0px;")
            self.scan_summary_secondary_label.setVisible(False)
            measurement_outer.addWidget(self.scan_summary_secondary_label)

            status_outer.addWidget(measurement_group)

            alignment_group = QGroupBox("Alignment")
            alignment_group.setStyleSheet(WINDOW_GROUPBOX_STYLE)
            alignment_layout = QGridLayout(alignment_group)
            alignment_layout.setHorizontalSpacing(8)
            alignment_layout.setVerticalSpacing(6)
            self.alignment_scale_label = QLabel("Signal Voltage | Best: --")
            self.alignment_scale_label.setTextInteractionFlags(Qt.TextSelectableByMouse)
            self.alignment_scale_label.setStyleSheet("padding-top: 0px; padding-bottom: 0px;")
            self.alignment_bar = AlignmentStrengthBar(0.0, 5000.0)
            self.alignment_bar.setMinimumWidth(280)
            self.alignment_bar.setMaximumWidth(340)
            self.live_hold_combo = QComboBox()
            self.live_hold_combo.setToolTip("Choose whether the live alignment value is shown raw or averaged over recent samples")
            self.live_hold_combo.addItems(["Raw live value", "5 sample average", "10 sample average"])
            self.free_measure_button = QPushButton("Live Measure")
            self.free_measure_button.setMinimumHeight(24)
            self.free_measure_button.setMaximumWidth(110)
            self.free_measure_button.setStyleSheet(BUTTON_ACTIVE_STYLE + " padding: 0 10px;")
            self.free_measure_button.clicked.connect(lambda checked=False, c="FREE": self._send_command(c))
            self.control_buttons["FREE"] = self.free_measure_button
            self.stop_live_button = QPushButton("Stop")
            self.stop_live_button.setMinimumHeight(24)
            self.stop_live_button.setMaximumWidth(110)
            self.stop_live_button.setStyleSheet(BUTTON_DISABLED_STYLE + " padding: 0 10px;")
            self.stop_live_button.setToolTip("Stop the live measurement mode")
            self.stop_live_button.clicked.connect(lambda checked=False, c="STOP": self._send_command(c))
            self.reset_best_button = QPushButton("Reset best")
            self.reset_best_button.setMinimumHeight(24)
            self.reset_best_button.setMaximumWidth(110)
            self.reset_best_button.setStyleSheet(RESET_BEST_BUTTON_STYLE)
            self.reset_best_button.setToolTip("Clear the best alignment marker and start tracking again")
            self.reset_best_button.clicked.connect(self._reset_peak)

            control_row = QHBoxLayout()
            control_row.setContentsMargins(0, 0, 0, 0)
            control_row.setSpacing(10)
            control_row.addWidget(QLabel("Live value mode"), 0)
            control_row.addWidget(self.live_hold_combo, 1)
            control_row.addWidget(self.free_measure_button, 0)
            control_row.addWidget(self.stop_live_button, 0)
            control_row.addWidget(self.reset_best_button, 0)
            self.trend_live_checkbox = QCheckBox("Trend On")
            self.trend_live_checkbox.setChecked(True)
            self.trend_live_checkbox.toggled.connect(lambda _v: self._redraw_alignment_plot())
            control_row.addWidget(self.trend_live_checkbox, 0)
            alignment_layout.addLayout(control_row, 0, 0, 1, 4)

            signal_row = QHBoxLayout()
            signal_row.setContentsMargins(0, 10, 0, 2)
            signal_row.setSpacing(10)
            signal_row.addStretch(1)
            signal_row.addWidget(self.alignment_scale_label, 0, Qt.AlignVCenter)
            signal_row.addWidget(self.alignment_bar, 1)
            signal_row.addStretch(1)
            trend_header = QHBoxLayout()
            trend_header.setContentsMargins(0, 0, 0, 0)
            trend_header.setSpacing(6)
            trend_title = QLabel("Live Alignment Trend")
            trend_title.setAlignment(Qt.AlignCenter)
            trend_title.setStyleSheet("font-size: 14px; font-weight: 600; background: transparent; border: none; padding: 0px; margin: 0px;")
            trend_header.addWidget(self.trend_live_checkbox, 0, Qt.AlignLeft | Qt.AlignVCenter)
            trend_header.addStretch(1)

            alignment_layout.addLayout(signal_row, 1, 0, 1, 4)
            alignment_layout.addLayout(trend_header, 2, 0, 1, 4)
            self.alignment_figure = Figure(figsize=(4.0, 3.0), dpi=100)
            self.alignment_ax = self.alignment_figure.add_subplot(111)
            self.alignment_canvas = FigureCanvas(self.alignment_figure)
            self.alignment_canvas.setMinimumHeight(100)

            alignment_graph_container = QWidget()
            alignment_graph_container.setStyleSheet("background-color: #ffffff; border: 1px solid #d9d9d9;")
            alignment_graph_layout = QVBoxLayout(alignment_graph_container)
            alignment_graph_layout.setContentsMargins(8, 2, 8, 8)
            alignment_graph_layout.setSpacing(1)
            alignment_graph_layout.addWidget(trend_title, 0, Qt.AlignHCenter)
            alignment_graph_layout.addWidget(self.alignment_canvas, 1)

            alignment_layout.addWidget(alignment_graph_container, 3, 0, 1, 4)
            status_outer.addWidget(alignment_group)
            status_outer.addStretch(1)

            status_scroll = QScrollArea()
            status_scroll.setWidgetResizable(True)
            status_scroll.setFrameShape(QFrame.NoFrame)
            status_scroll.setHorizontalScrollBarPolicy(Qt.ScrollBarAlwaysOff)
            status_scroll.setWidget(status_panel)
            right_graph_layout.addWidget(status_scroll, 1)

            graph_splitter.addWidget(right_graph_column)
            self.parser.draw_plot(self.ax, "", POLARITY_LOWER_IS_MORE)
            self._redraw_alignment_plot()
            self.canvas.draw()
            graph_splitter.setSizes([1060, 350])

        self.left_content_panel = QWidget()
        left_content_layout = QHBoxLayout(self.left_content_panel)
        left_content_layout.setContentsMargins(0, 0, 0, 0)
        left_content_layout.setSpacing(0)
        left_content_layout.addWidget(graphs_panel, 1)

        self.show_log_edge_button = QPushButton("S\ne\nr\ni\na\nl\n \nL\no\ng")
        self.show_log_edge_button.setToolTip("Show serial log")
        self.show_log_edge_button.setFixedWidth(20)
        self.show_log_edge_button.setSizePolicy(QSizePolicy.Fixed, QSizePolicy.Expanding)
        self.show_log_edge_button.setVisible(False)
        self.show_log_edge_button.clicked.connect(self._show_log_panel)
        self.show_log_edge_button.setStyleSheet("padding: 6px 2px; font-size: 9px; font-weight: 700; color: #1f2f3d; background-color: #a9bac9; border: 1px solid #7f95a8; border-radius: 4px;")
        left_content_layout.addWidget(self.show_log_edge_button, 0)
        content_splitter.addWidget(self.left_content_panel)

        self._log_panel = self._make_panel_frame()
        log_panel = self._log_panel
        log_layout = QVBoxLayout(log_panel)
        log_header_top = QHBoxLayout()
        log_header_top.addWidget(QLabel("Serial log"))
        log_header_top.addStretch(1)
        self.pause_log_button = QPushButton("Pause")
        self.pause_log_button.setMinimumHeight(26)
        self.pause_log_button.setMinimumWidth(56)
        self.pause_log_button.setStyleSheet("padding: 3px 10px;")
        self.pause_log_button.clicked.connect(self._toggle_log_pause)
        log_header_top.addWidget(self.pause_log_button)
        collapse_button = QPushButton("▶")
        collapse_button.setToolTip("Collapse serial log")
        collapse_button.setMinimumHeight(26)
        collapse_button.setStyleSheet("padding: 3px 8px;")
        collapse_button.setMinimumWidth(34)
        collapse_button.clicked.connect(self._hide_log_panel)
        log_header_top.addWidget(collapse_button)
        log_layout.addLayout(log_header_top)

        log_header_bottom = QHBoxLayout()
        log_header_bottom.addStretch(1)
        save_log_button = QPushButton("Save log")
        save_log_button.setMinimumHeight(26)
        save_log_button.setMinimumWidth(72)
        save_log_button.setStyleSheet("padding: 3px 10px;")
        save_log_button.clicked.connect(self._save_log)
        log_header_bottom.addWidget(save_log_button)
        clear_log_button = QPushButton("Clear log")
        clear_log_button.setMinimumHeight(26)
        clear_log_button.setMinimumWidth(72)
        clear_log_button.setStyleSheet("padding: 3px 10px;")
        clear_log_button.clicked.connect(self._clear_log)
        log_header_bottom.addWidget(clear_log_button)
        log_layout.addLayout(log_header_bottom)
        self.log_box = QPlainTextEdit()
        self.log_box.setReadOnly(True)
        log_layout.addWidget(self.log_box)
        content_splitter.addWidget(log_panel)

        log_panel.setMinimumWidth(96)
        log_panel.setMaximumWidth(16777215)
        content_splitter.setSizes([1360, 180])

        self.resolution_status_label = QLabel("Window: 0 × 0 px")
        self.resolution_status_label.setAlignment(Qt.AlignLeft | Qt.AlignVCenter)
        self.resolution_status_label.setMinimumWidth(150)
        self.statusBar().addPermanentWidget(self.resolution_status_label)

        # shortcuts
        QShortcut(QKeySequence("S"), self, activated=lambda: self._send_command("START"))
        QShortcut(QKeySequence("X"), self, activated=lambda: self._send_command("STOP"))
        QShortcut(QKeySequence("F"), self, activated=lambda: self._send_command("FREE"))
        QShortcut(QKeySequence("H"), self, activated=lambda: self._send_command("HOME"))
        QShortcut(QKeySequence("Ctrl+S"), self, activated=self._save_csv)
        QShortcut(QKeySequence("Ctrl+P"), self, activated=self._save_png)

        self._load_settings()
        QTimer.singleShot(0, self._apply_persisted_ui_state)
        QTimer.singleShot(100, self._apply_persisted_ui_state)
        self._update_measurement_setup_summary()
        self._update_control_states()
        self._set_laser_button_state()
        self._set_position_button_states()
        self._refresh_status_labels()
        self._refresh_scan_list()
        self._update_resolution_indicator()
        self.statusBar().showMessage("Ready")


    def _apply_startup_window_layout(self):
        if self._startup_geometry_applied:
            return
        screen = self.screen() or QApplication.primaryScreen()
        if screen is None:
            self._startup_geometry_applied = True
            self._update_resolution_indicator()
            return

        available = screen.availableGeometry()

        # Fit to the actual usable laptop window area, not the nominal panel size.
        # Keep the window as large as practical, while reserving a small safety margin
        # so all regions remain visible on typical laptop screens.
        safe_margin_w = 12
        safe_margin_h = 12

        target_width = min(available.width() - safe_margin_w, 1880)
        target_height = min(available.height() - safe_margin_h, 1000)

        target_width = max(self.minimumWidth(), target_width)
        target_height = max(self.minimumHeight(), target_height)

        target_width = min(target_width, available.width() - 4)
        target_height = min(target_height, available.height() - 4)

        x = available.x() + max(0, (available.width() - target_width) // 2)
        y = available.y() + max(0, (available.height() - target_height) // 2)
        self.setGeometry(x, y, target_width, target_height)

        if self.content_splitter is not None:
            total_w = max(1, self.width())
            right_w = max(140, min(260, int(total_w * 0.10)))
            left_w = max(900, total_w - right_w)
            self.content_splitter.setSizes([left_w, right_w])


        if self.main_plot_splitter is not None:
            total_h = max(1, self.main_plot_splitter.height() or int(self.height() * 0.76))
            top_h = int(total_h * 0.40)
            mid_h = int(total_h * 0.38)
            bot_h = max(145, total_h - top_h - mid_h)
            self.main_plot_splitter.setSizes([top_h, mid_h, bot_h])

        self._startup_geometry_applied = True
        self._update_resolution_indicator()

    def _update_resolution_indicator(self):
        if self.resolution_status_label is None:
            return
        self.resolution_status_label.setText(f"Window: {self.width()} × {self.height()} px")

    def showEvent(self, event):
        super().showEvent(event)
        self._apply_startup_window_layout()
        self._update_resolution_indicator()

    def resizeEvent(self, event):
        super().resizeEvent(event)
        self._update_resolution_indicator()



    def _show_settings_dialog(self):
        dialog = QDialog(self)
        dialog.setWindowTitle("Settings")
        dialog.setMinimumWidth(420)
        layout = QVBoxLayout(dialog)

        info = QLabel(
            "Software settings are saved automatically when the application closes.\n\n"
            "They are stored in a JSON settings file placed in the same folder as the software.\n\n"
            "Current saved settings include serial port, diode model, signal polarity, output folder, notes, "
            "operator, diode type, diffuser used, bench configuration, test ID, scan speed, and return speed."
        )
        info.setWordWrap(True)
        layout.addWidget(info)

        buttons = QDialogButtonBox(QDialogButtonBox.Close)
        buttons.rejected.connect(dialog.reject)
        buttons.accepted.connect(dialog.accept)
        layout.addWidget(buttons)
        dialog.exec()
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
