Nortcel/cosine-response-test-bench/(commit log)

2026-11-08 Add controller, firmware, manuals and hardware files
    [Bill_of_materials_corrected.xlsx, Commissioning record.csv, Cosine_Response_Test_Bench_Alignment_Stand.skp, Cosine_Response_Test_Bench_Laser_Cover.skp, FIGURE MANIFEST.csv, LICENCE MAP.csv, pinout.csv, serial_protocol_V5.2.2.csv]
2026-11-08 Add measurement data, analysis and figures
    [01_processed.csv, 02_processed.csv, 03_processed.csv, 04_processed.csv, 05_processed.csv, 06_processed.csv, 07_processed.csv, 08_processed.csv]
2026-11-08 Add minimal public software and hardware package
    [1080-1143-ND Diode Measurement V1.xlsx, 1080-1143-ND_x3_10072017_cos_response_data.csv, 1080-1144-ND Diode Measurement V1.xlsx, 1080-1144-ND_x3_11072017_cos_response_data.csv, 1080-1148-ND Diode Measurement V1.xlsx, 1080-1148-ND_x3_10072017_cos_response_data.csv, 475-1077-ND Diode Measurement V1.xlsx, 475-1077-ND_x3_10072017_cos_response_data.csv]
